JefferyWenn/EE400-Chip-Testing/file/EE400 - Memory Revival Sims & Layout.pdf

## Memory Revival Sims & Layout

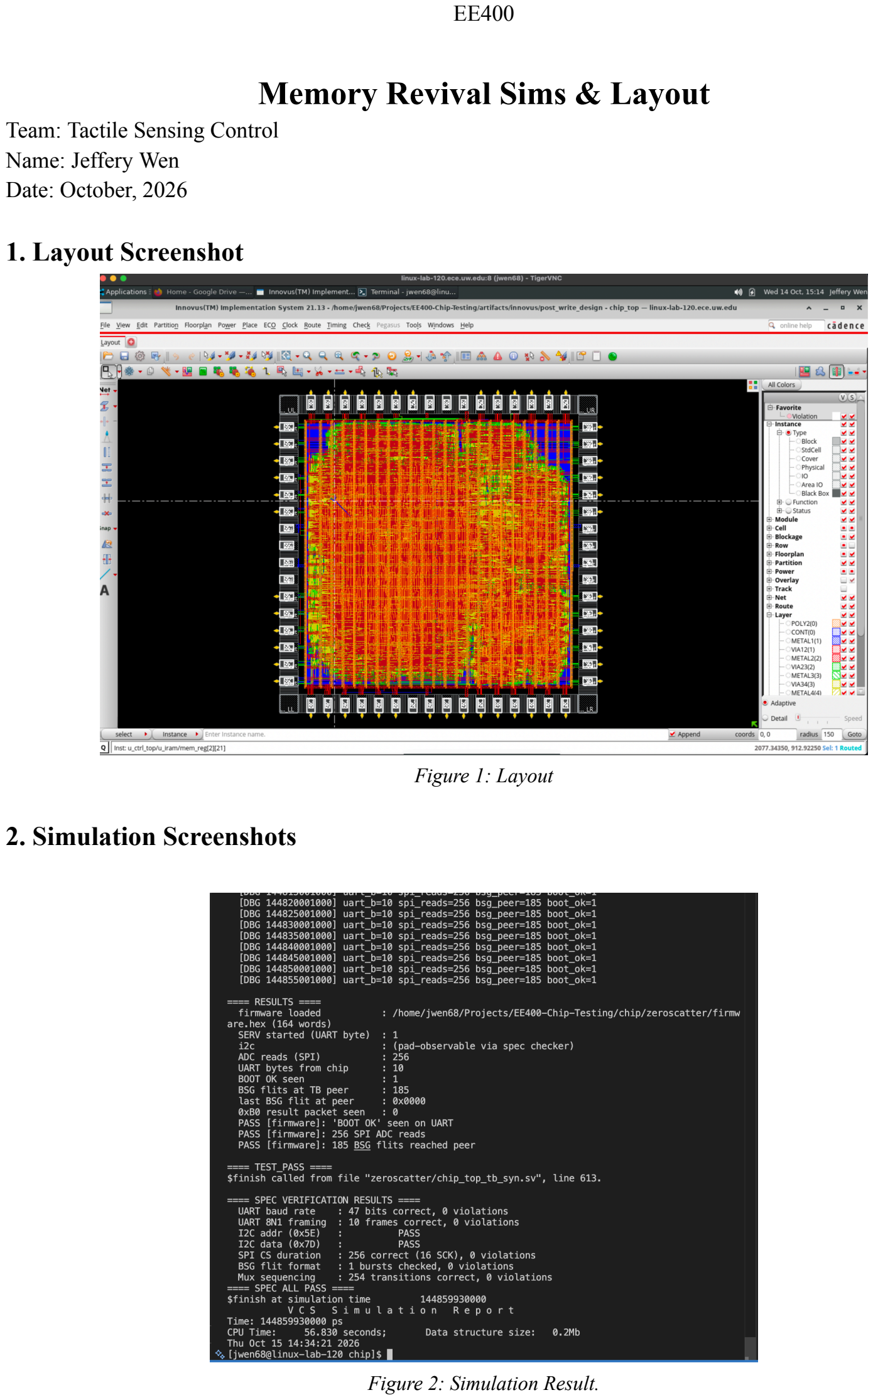
[picture p5: page 1]

EE400

Team: Tactile Sensing Control Name: Jeffery Wen
Date: October, 2026

### 1. Layout Screenshot

Figure 1: Layout

### 2. Simulation Screenshots

Figure 2: Simulation Result.

EE400

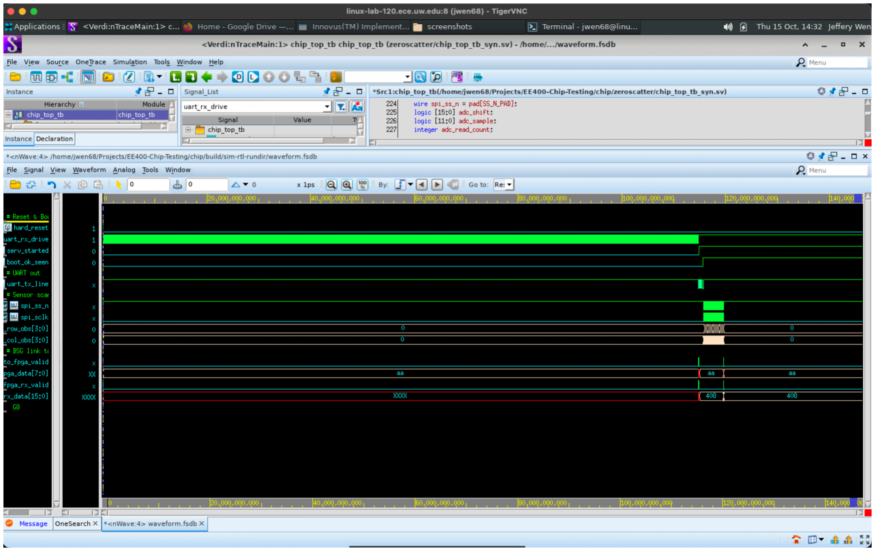
[picture p6: figure]

Figure 3: Simulation waveform.

### 3. Bring-up plan

We will test the chip step by step, starting with basic checks and then testing the full system.

Milestone 1: Any sign of life. Power up the chip (1.8 V core, 3.3 V IO), apply a clock and reset, and look for any activity on the outputs, such as the UART reply or the scan chain output. Any correct signal from the chip counts as success.

Milestone 2: Sub-modules work. Test each block on its own at a low clock (10 MHz):
- UART firmware loading and the "BOOT OK" message
- I²C sensor configuration
- SPI reads from the ADC and the mux scan across the 256 sensor cells
- the bsg_link chip-to-chip interface

Milestone 3: Test the full system at low speed. Run the complete process at 10 MHz: scan all 256 sensor cells, send the data to the conv chip, and receive the result through UART. If the results are correct, it shows that the full design works on the chip.

Milestone 4: Check the design targets. Increase the clock speed toward the original 50 MHz target and measure:
- The highest working clock speed at different supply voltages
- The frame rate (frames per second) of the full system
- Power use and energy used per frame

Milestone 5: Try other applications. After confirming that the chip works, explore its use in other sensing devices in Prof. Luo's lab, beyond the tactile glove.
