JefferyWenn/EE400-Chip-Testing/docs/clk_data_delay_output.png

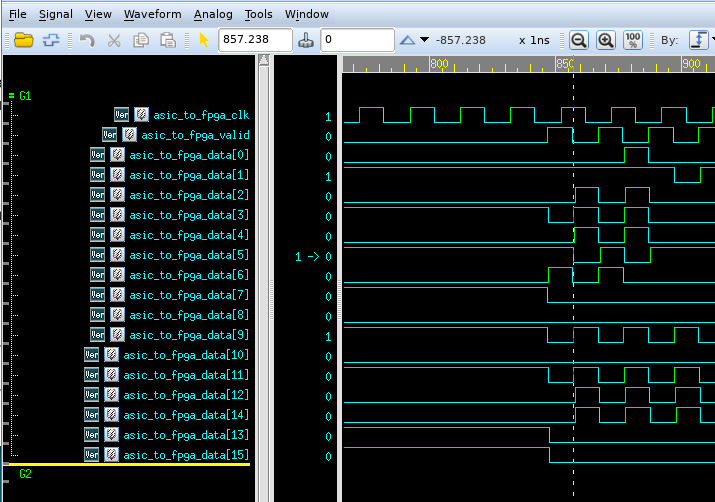
docs/clk_data_delay_output.png
