JefferyWenn/EE400-Chip-Testing/screenshots/Screenshot 2026-10-14 at 3.14.47 PM.png

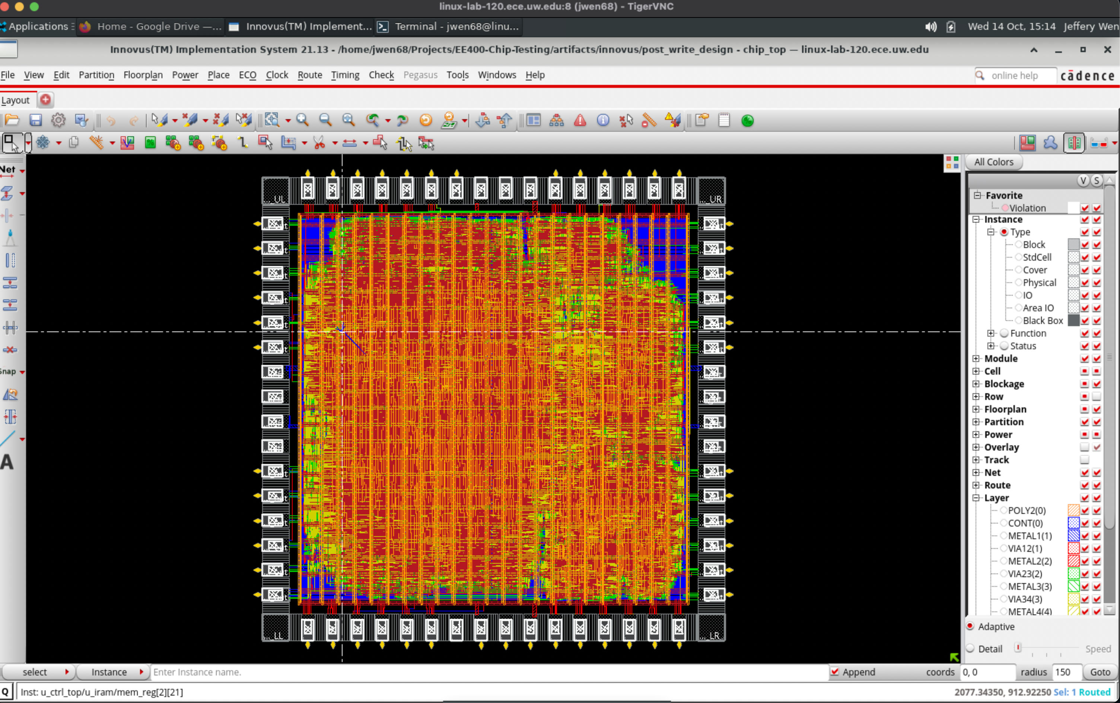
screenshots/Screenshot 2026-10-14 at 3.14.47 PM.png
