JefferyWenn/EE400-Chip-Testing/screenshots/Screenshot 2026-10-15 at 2.32.01 PM.png

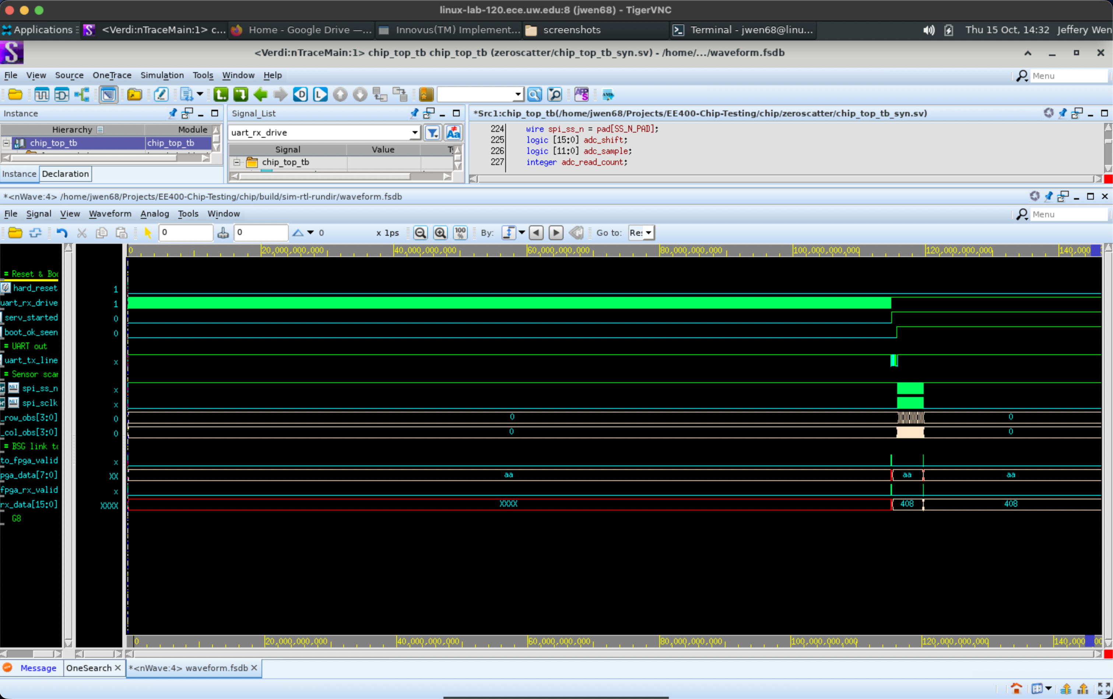
screenshots/Screenshot 2026-10-15 at 2.32.01 PM.png
