JefferyWenn/EE400-Chip-Testing/screenshots/Screenshot 2026-10-15 at 2.34.30 PM.png

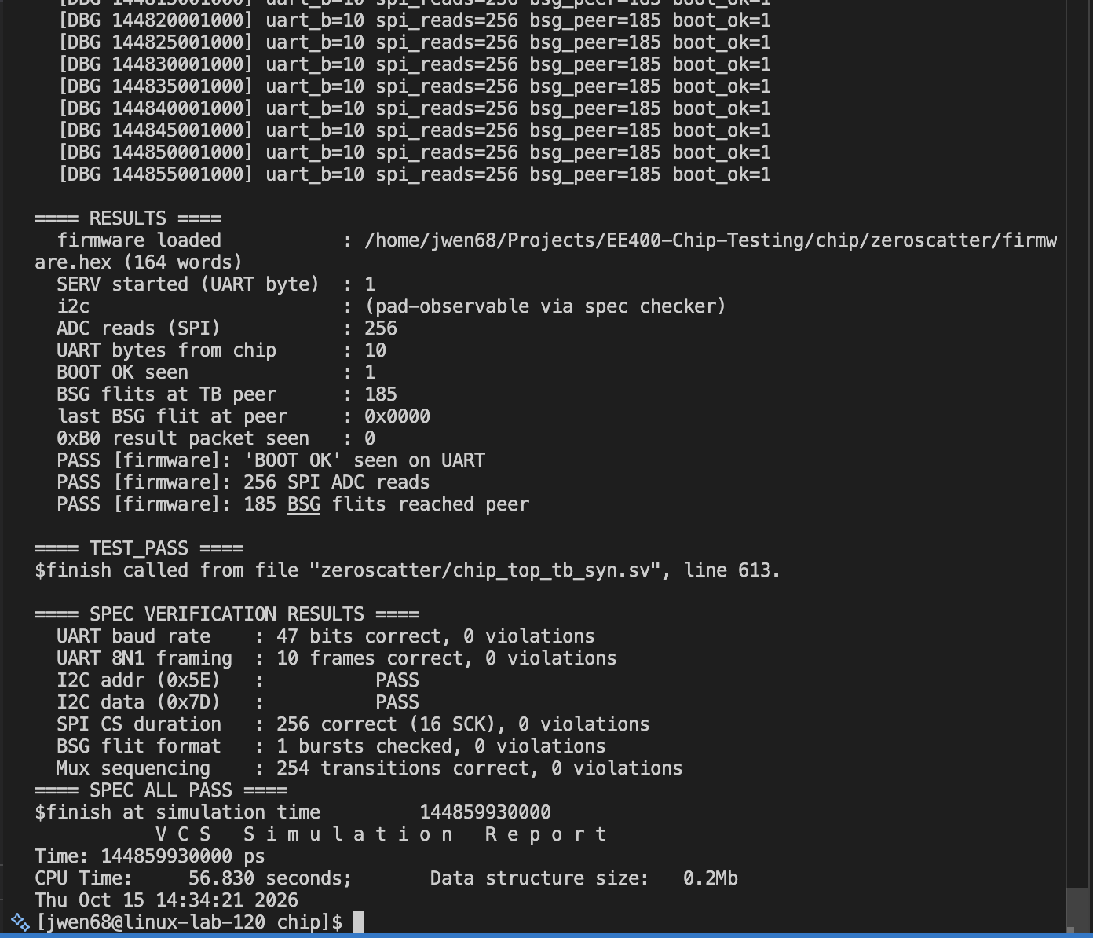
screenshots/Screenshot 2026-10-15 at 2.34.30 PM.png
