JefferyWenn/EE400-Chip-Testing/chip/zeroscatter/chip_top_tb.sv

// =====================================================================
// chip_top_tb.sv  —  Functional testbench for the tactile-sensing SoC
//
// Exercises the REAL design: firmware-driven SERV SoC that boots, scans
// 256 sensor cells over SPI, DMA-offloads them to a DLA over the BSG
// link, and streams a result packet back out over UART.
//
// TB actors:
//   1. Clock/reset driver    — core_clk PAD[44], hard_reset PAD[45]
//   2. Firmware loader       — FAST backdoor into IRAM (default), or real
//                              UART feed on PAD[24] (FAST_LOAD=0)
//   3. SPI ADC mock (AD7466) — drives MISO PAD[25] with fake samples when
//                              the chip drives SCLK PAD[13]/SS_n PAD[26]
//   4. BSG DLA mock          — bsg_link peer; drains chip BSG TX (so the
//                              DMA completes) and sends result flits back
//   5. UART TX monitor       — decodes PAD[27], detects "BOOT OK"
//
// Pass criteria (each failure increments errors):
//   - i2c_done asserts
//   - SERV comes out of reset and fetches (PC advances)
//   - "BOOT OK" string seen on UART TX
//   - chip emits >=1 BSG TX flit (proves scan + DMA ran)
//
// FROZEN-RTL NOTE: this chip_top wires ctrl_top.nRESET (active-low) to
// core_link_reset_int (active-high), which holds the core in reset forever.
// Since RTL is frozen, the TB FORCES nRESET high after the bsg reset
// sequencer settles (FORCE_NRESET=1). Remove once the RTL bug is fixed.
// =====================================================================
`timescale 1ps/1ps

module chip_top_tb;

    // ---- knobs ----
    // FAST_LOAD / DLA_RESPOND / DLA_EARLY are runtime-selectable so individual
    // +TEST cases can flip them (e.g. test_uart_boot exercises the REAL UART
    // firmware_loader with FAST_LOAD=0; test_rx fires the DLA mock immediately,
    // decoupled from the outbound DMA burst). Defaults below match the legacy
    // behaviour and are overridden in load_fw_file() per test_name.
    logic FAST_LOAD;                     // 1: backdoor IRAM. 0: real UART feed.
    localparam bit FORCE_NRESET = 1'b1;  // work around frozen nRESET wiring bug
    logic DLA_RESPOND;                   // DLA mock sends result flits back
    logic DLA_EARLY;                     // 1: DLA responds as soon as chip runs
                                         //    (decouples RX path from TX burst)

    localparam int FLIT_WIDTH    = 16;
    localparam int CHANNEL_WIDTH = 8;
    localparam int FW_MAX        = 1024;
    // Default firmware directory. Test selected by +TEST=name; directory can
    // be overridden by +FWDIR=/abs/path/ so the same simv runs on a grader's
    // machine without rebuilding. Keep the trailing slash on any override.
    localparam string FW_DIR_DEFAULT =
        "/home/jwen68/Projects/EE400-Chip-Testing/chip/zeroscatter/";
    string fw_dir;
    string fw_hex_path;

    localparam int      BAUD   = 115_200;
    localparam realtime BIT_PS = 1.0e12 / BAUD;   // real so # delays are exact

    // ---- pad indices (from chip_top.sv) ----
    localparam CORE_CLK_PAD=44, HARD_RESET_PAD=45;
    localparam DN_CLK_PAD=8, DN_VALID_PAD=9, DN_TOKEN_PAD=10, TOKEN_CLK_PAD=12;
    localparam UP_VALID_PAD=14, UP_CLK_PAD=15;
    localparam SCLK_PAD=13, MISO_PAD=25, SS_N_PAD=26;
    localparam UART_RX_PAD=24, UART_TX_PAD=27;
    localparam I2C_SCL_PAD=28, I2C_SDA_PAD=29;
    localparam MUX_ROW0_PAD=36, MUX_COL0_PAD=40;
    // At 50 MHz each core_clk period = 20 000 ps.
    // UART baud = 115 200 → divider = floor(50e6/115200) = 434 clocks/bit.
    localparam realtime BIT_PS_RTL = 434.0 * 20000.0; // 8 680 000 ps per bit

    // =================================================================
    //  Clocks + globals
    // =================================================================
    logic core_clk, dn_io_clk, hard_reset;
    logic fpga_core_reset, fpga_tx_io_link_reset, fpga_tx_async_token_reset;
    logic fpga_rx_io_link_reset, fpga_rx_io_link_reset_sync;

    initial begin core_clk = 0;  forever #10000 core_clk = ~core_clk; end
    initial begin dn_io_clk = 0; forever #10000 dn_io_clk = ~dn_io_clk; end

    // =================================================================
    //  Pad bus
    // =================================================================
    wire vdd_io = 1'b1, vss_io = 1'b0;
    tri  [47:0] pad;
    logic [47:0] pad_drv, pad_oe;

    function automatic logic kz(input logic v); kz = (v===1'b1)?1'b1:1'b0; endfunction

    genvar gi;
    generate
        for (gi=0; gi<48; gi++) begin: gen_pad
            assign pad[gi] = pad_oe[gi] ? pad_drv[gi] : 1'bz;
        end
    endgenerate

    chip_top uut (.PAD(pad), .VDDPST(vdd_io), .VSSPST(vss_io), .VDD(vdd_io), .VSS(vss_io));

    assign pad_drv[CORE_CLK_PAD]   = kz(core_clk);
    assign pad_drv[HARD_RESET_PAD] = kz(hard_reset);

    // =================================================================
    //  BSG link peer
    // =================================================================
    logic                     fpga_to_asic_clk, fpga_to_asic_valid, fpga_to_asic_token;
    logic [CHANNEL_WIDTH-1:0] fpga_to_asic_data;
    logic                     asic_to_fpga_clk, asic_to_fpga_valid, asic_to_fpga_token;
    logic [CHANNEL_WIDTH-1:0] asic_to_fpga_data;

    assign pad_drv[DN_CLK_PAD]    = kz(fpga_to_asic_clk);
    assign pad_drv[DN_VALID_PAD]  = kz(fpga_to_asic_valid);
    assign pad_drv[0]=kz(fpga_to_asic_data[0]); assign pad_drv[1]=kz(fpga_to_asic_data[1]);
    assign pad_drv[2]=kz(fpga_to_asic_data[2]); assign pad_drv[3]=kz(fpga_to_asic_data[3]);
    assign pad_drv[4]=kz(fpga_to_asic_data[4]); assign pad_drv[5]=kz(fpga_to_asic_data[5]);
    assign pad_drv[6]=kz(fpga_to_asic_data[6]); assign pad_drv[7]=kz(fpga_to_asic_data[7]);
    assign pad_drv[TOKEN_CLK_PAD] = kz(fpga_to_asic_token);

    assign asic_to_fpga_clk   = pad[UP_CLK_PAD];
    assign asic_to_fpga_valid = pad[UP_VALID_PAD];
    assign asic_to_fpga_token = pad[DN_TOKEN_PAD];
    assign asic_to_fpga_data[0]=pad[22]; assign asic_to_fpga_data[1]=pad[23];
    assign asic_to_fpga_data[2]=pad[20]; assign asic_to_fpga_data[3]=pad[21];
    assign asic_to_fpga_data[4]=pad[18]; assign asic_to_fpga_data[5]=pad[19];
    assign asic_to_fpga_data[6]=pad[16]; assign asic_to_fpga_data[7]=pad[17];

    logic [FLIT_WIDTH-1:0] fpga_tx_data, fpga_rx_data;
    logic fpga_tx_valid, fpga_tx_ready, fpga_rx_valid, fpga_rx_yumi;

    bsg_link_ddr_upstream #(
        .width_p(FLIT_WIDTH), .channel_width_p(CHANNEL_WIDTH),
        .num_channels_p(1), .lg_fifo_depth_p(6)
    ) fpga_tx_link (
        .core_clk_i(core_clk), .core_link_reset_i(fpga_core_reset),
        .core_data_i(fpga_tx_data), .core_valid_i(fpga_tx_valid), .core_ready_o(fpga_tx_ready),
        .io_clk_i(dn_io_clk), .io_link_reset_i(fpga_tx_io_link_reset),
        .async_token_reset_i(fpga_tx_async_token_reset),
        .io_clk_r_o(fpga_to_asic_clk), .io_data_r_o(fpga_to_asic_data),
        .io_valid_r_o(fpga_to_asic_valid), .token_clk_i(asic_to_fpga_token)
    );

    bsg_sync_sync #(.width_p(1)) fpga_rx_reset_sync (
        .oclk_i(asic_to_fpga_clk), .iclk_data_i(fpga_rx_io_link_reset),
        .oclk_data_o(fpga_rx_io_link_reset_sync)
    );

    bsg_link_ddr_downstream #(
        .width_p(FLIT_WIDTH), .channel_width_p(CHANNEL_WIDTH),
        .num_channels_p(1), .lg_fifo_depth_p(6)
    ) fpga_rx_link (
        .core_clk_i(core_clk), .core_link_reset_i(fpga_core_reset),
        .io_link_reset_i(fpga_rx_io_link_reset_sync),
        .core_data_o(fpga_rx_data), .core_valid_o(fpga_rx_valid), .core_yumi_i(fpga_rx_yumi),
        .io_clk_i(asic_to_fpga_clk), .io_data_i(asic_to_fpga_data),
        .io_valid_i(asic_to_fpga_valid), .core_token_r_o(fpga_to_asic_token)
    );

    // =================================================================
    //  DLA mock — drain chip TX; echo result flits after a full burst
    // =================================================================
    integer chip_tx_count;
    integer chip_bsg_accept_count;   // chip-internal BSG TX accept counter (firmware-direct only)
    integer dma_engine_flit_count;   // flits the DMA engine itself emits (u_up_ctl boundary)
    logic   dma_done_seen;           // BSG_UP_ST.done (u_up_ctl.o_done) ever asserted
    logic   dma_busy_seen;           // DMA engine ever entered busy
    logic   cnn_buf_ready_seen;       // moved to module scope (VCS error)
    logic [FLIT_WIDTH-1:0] chip_tx_last;

    assign fpga_rx_yumi = fpga_rx_valid;   // always accept

    always_ff @(posedge core_clk) begin
        if (fpga_core_reset) begin chip_tx_count <= 0; chip_tx_last <= '0; end
        else if (fpga_rx_valid && fpga_rx_yumi) begin
            chip_tx_count <= chip_tx_count + 1;
            chip_tx_last  <= fpga_rx_data;
        end
    end

    integer dla_idx;
    logic   responded;
    localparam int BURST_THRESHOLD = 258;   // chip sends ~259 flits, trigger when most are done

    // Early-arm: once the chip core is out of reset (serv_rst_n high) plus a
    // settling delay, allow the DLA mock to respond WITHOUT waiting for the
    // outbound DMA burst. Used by test_rx to exercise the RX -> cnn_result_buf
    // -> pkt_framer -> UART 0xB0 path in isolation.
    integer dla_early_cnt;
    logic   dla_early_armed;
    always_ff @(posedge core_clk) begin
        if (fpga_core_reset) begin
            dla_early_cnt   <= 0;
            dla_early_armed <= 1'b0;
        // RTL: gate on serv_rst_n; gate-level: gate on fpga_core_reset deassert
        // (fixed 2000-cycle settle, same effect since SERV starts shortly after)
`ifdef RTL_SIM
        end else if (uut.u_ctrl_top.serv_rst_n === 1'b1) begin
`else
        end else begin
`endif
            if (dla_early_cnt < 2000) dla_early_cnt <= dla_early_cnt + 1;
            else                      dla_early_armed <= 1'b1;
        end
    end
    // The DLA mock starts streaming its response when either trigger is true.
    wire dla_trigger = DLA_EARLY ? dla_early_armed
                                 : (chip_tx_count >= BURST_THRESHOLD);

    // 14-flit result packet:
    //   flit 0: HDR_HI with bits[3:2]=01 (PKT_DATA) — any value that has bits[3:2]=01
    //   flit 1: HDR_LO with bits[8:0]=12 (len)
    //   flits 2..13: 12 body flits → fill cnn_result_buf → buf_ready → pkt_framer fires
    function automatic [15:0] dla_resp_flit(input integer i);
        case (i)
            0: dla_resp_flit = 16'h0004;            // bits[3:2]=01 (PKT_DATA)
            1: dla_resp_flit = 16'h000C;            // len = 12
            default: dla_resp_flit = 16'hC000 | i;  // body flits 0xC002..0xC00D
        endcase
    endfunction

    // NOTE: fpga_tx_valid/data, dla_idx, responded reset inside this
    // always_ff ONLY — VCS forbids a second driver, so no initial block.
    always_ff @(posedge core_clk) begin
        if (fpga_core_reset) begin
            fpga_tx_valid<=0; fpga_tx_data<='0; dla_idx<=0; responded<=0;
        end else if (DLA_RESPOND && !responded && dla_trigger) begin
            if (fpga_tx_ready) begin
                fpga_tx_valid <= 1'b1;
                fpga_tx_data  <= dla_resp_flit(dla_idx);
                dla_idx <= dla_idx + 1;
                if (dla_idx == 13) responded <= 1'b1;
            end else fpga_tx_valid <= 1'b0;
        end else fpga_tx_valid <= 1'b0;
    end

    // =================================================================
    //  SPI ADC mock (AD7466)
    // =================================================================
    wire spi_sclk = pad[SCLK_PAD];
    wire spi_ss_n = pad[SS_N_PAD];
    logic [15:0] adc_shift;
    logic [11:0] adc_sample;
    integer adc_read_count;

    initial begin adc_sample=12'h080; adc_read_count=0; adc_shift='0; end
    always @(negedge spi_ss_n) begin
        adc_shift = {4'b0000, adc_sample};
        adc_read_count = adc_read_count + 1;
        adc_sample = adc_sample + 12'h007;
    end
    always @(negedge spi_sclk) if (!spi_ss_n) adc_shift = {adc_shift[14:0], 1'b0};
    assign pad_drv[MISO_PAD] = adc_shift[15];

    // =================================================================
    //  UART feeder (FAST_LOAD=0) + monitor
    // =================================================================
    logic uart_rx_drive;
    assign pad_drv[UART_RX_PAD] = uart_rx_drive;

    task automatic uart_send_byte(input [7:0] b);
        integer i;
        begin
            uart_rx_drive=1'b0; #(BIT_PS);
            for (i=0;i<8;i++) begin uart_rx_drive=b[i]; #(BIT_PS); end
            uart_rx_drive=1'b1; #(BIT_PS);
        end
    endtask
    task automatic loader_send_word(input [31:0] addr, input [31:0] data);
        begin
            uart_send_byte(addr[31:24]); uart_send_byte(addr[23:16]);
            uart_send_byte(addr[15:8]);  uart_send_byte(addr[7:0]);
            uart_send_byte(data[31:24]); uart_send_byte(data[23:16]);
            uart_send_byte(data[15:8]);  uart_send_byte(data[7:0]);
        end
    endtask

    wire uart_tx_line = pad[UART_TX_PAD];
    integer uart_rx_byte_count;
    logic [8*8-1:0] uart_win;
    logic boot_ok_seen;
    logic pkt_b0_seen;
    logic [7:0] last_uart_byte;

    task automatic uart_recv_byte(output [7:0] b);
        integer i;
        begin
            @(negedge uart_tx_line);
            #(BIT_PS + BIT_PS/2);
            for (i=0;i<8;i++) begin b[i]=uart_tx_line; #(BIT_PS); end
        end
    endtask

    initial begin
        uart_rx_byte_count=0; boot_ok_seen=0; uart_win='0; last_uart_byte=0;
        pkt_b0_seen=0;
        forever begin
            logic [7:0] rb;
            uart_recv_byte(rb);
            last_uart_byte=rb; uart_rx_byte_count=uart_rx_byte_count+1;
            uart_win = {uart_win[8*7-1:0], rb};
            if (rb >= 8'h20 && rb < 8'h7f)
                $display("  [%0t] UART TX #%0d = 0x%02h ('%c')", $time, uart_rx_byte_count, rb, rb);
            else
                $display("  [%0t] UART TX #%0d = 0x%02h", $time, uart_rx_byte_count, rb);
            if (uart_win == {"B","O","O","T"," ","O","K"}) boot_ok_seen=1;
            if (rb == 8'hB0) begin
                pkt_b0_seen = 1;
                $display("  [%0t] >> 0xB0 result packet header seen on UART!", $time);
            end
        end
    end

    // =================================================================
    //  Firmware image
    // =================================================================
    logic [31:0] fw_mem [0:FW_MAX-1];
    integer fw_words;
    string  test_name_g;   // set by load_fw_file; used for per-test pass criteria

    task automatic load_fw_file;
        integer i;
        string  test_name;
        begin
            // Pick which hex via +TEST=name plusarg. Default: firmware
            if (!$value$plusargs("TEST=%s", test_name)) test_name = "firmware";
            test_name_g = test_name;
            // Directory: +FWDIR=... overrides the baked-in absolute path.
            if (!$value$plusargs("FWDIR=%s", fw_dir)) fw_dir = FW_DIR_DEFAULT;
            fw_hex_path = {fw_dir, test_name, ".hex"};

            // ---- Per-test knob defaults ----
            // Most tests: backdoor IRAM (fast), DLA responds after a full burst.
            FAST_LOAD   = 1'b1;
            DLA_RESPOND = 1'b1;
            DLA_EARLY   = 1'b0;
            case (test_name)
                // Real UART boot: drive firmware in over PAD[24] via the
                // on-chip firmware_loader instead of backdooring IRAM.
                "test_uart_boot": FAST_LOAD = 1'b0;
                // RX/0xB0 path in isolation: fire the DLA response immediately
                // so cnn_result_buf -> pkt_framer -> UART 0xB0 runs without
                // depending on the outbound DMA burst reaching the peer.
                "test_rx":        DLA_EARLY = 1'b1;
                default: ;  // keep defaults
            endcase

            $display("==== Loading firmware: %s ====", fw_hex_path);
            $display("====   FAST_LOAD=%0b DLA_RESPOND=%0b DLA_EARLY=%0b ====",
                     FAST_LOAD, DLA_RESPOND, DLA_EARLY);
            for (i=0;i<FW_MAX;i++) fw_mem[i]=32'hxxxx_xxxx;
            $readmemh(fw_hex_path, fw_mem);
            fw_words=0;
            for (i=0;i<FW_MAX;i++) if (fw_mem[i]!==32'hxxxx_xxxx) fw_words=i+1;
            $display("Loaded %0d firmware words", fw_words);
            if (fw_words==0) $display("ERROR: no firmware loaded - check FW path!");
        end
    endtask

    // ---- Spec verification variables (declared here for forward-ref) ----
    int      uart_baud_ok, uart_baud_err;
    realtime uart_last_trans_ps;
    logic    uart_baud_armed;
    int      uart_frame_err, uart_frame_ok;
    logic [7:0] i2c_addr_captured, i2c_data_captured;
    logic       i2c_addr_valid, i2c_data_valid;
    int         i2c_spec_err;
    int spi_sck_per_cs, spi_cs_spec_ok, spi_cs_spec_err;
    int  bsg_flit_spec_err, bsg_burst_count, bsg_flit_idx_in_burst;
    logic bsg_in_burst;
    logic [3:0] mux_row_obs, mux_col_obs;
    logic [7:0] mux_prev_cell     = 8'd0;
    logic [7:0] mux_curr_cell     = 8'd0;
    logic [7:0] mux_expected_next = 8'd0;
    int         mux_seq_ok = 0, mux_seq_err = 0;
    logic       mux_first_cell = 1;

    // =================================================================
    //  Main sequence
    // =================================================================
    integer errors;
    logic   serv_started;

    initial begin
        // VCD dump disabled: full-design VCD is ~7 GB per run; waveform.fsdb below is used instead.
        // $dumpfile("chip_top_tb.vcd"); $dumpvars(0, chip_top_tb);
        $fsdbDumpfile("waveform.fsdb"); $fsdbDumpvars(0, chip_top_tb); $fsdbDumpMDA();

        errors=0; serv_started=0;
        hard_reset=1; fpga_core_reset=1;
        fpga_tx_io_link_reset=1; fpga_tx_async_token_reset=0; fpga_rx_io_link_reset=1;
        uart_rx_drive=1; pad_oe='0;

        load_fw_file();

        #1000;
        pad_oe[CORE_CLK_PAD]=1; pad_oe[HARD_RESET_PAD]=1;
        pad_oe[DN_CLK_PAD]=1; pad_oe[DN_VALID_PAD]=1; pad_oe[TOKEN_CLK_PAD]=1;
        pad_oe[UART_RX_PAD]=1; pad_oe[MISO_PAD]=1;
        for (int d=0; d<8; d++) pad_oe[d]=1;

        // bsg reset bring-up
        // Reset sequencing follows the bsg_link_ddr reference procedure:
        //   TX side: async_token_reset pulse → io_link_reset deassert
        //   Chip:    hard_reset deassert → internal sequencer runs (cnt 0..32)
        //   RX side: io_link_reset deassert after forwarded clk is stable
        //
        // ODDR phase fix: the forwarded clock (asic_to_fpga_clk) is generated
        // from negedges of core_clk. odd_r (which selects data_high vs
        // data_low+valid) starts at 0 after reset and toggles every core_clk.
        // The IDDR extracts the valid bit from data_p_r[8] (posedge sample).
        // For valid=1, posedge of asic_to_fpga_clk must align with odd_r=1
        // (data_low+valid half). Adding 1 extra core_clk before releasing
        // fpga_rx_io_link_reset shifts the phase by one cycle to achieve this.
        // Similarly, 1 extra dn_io_clk before fpga_tx_io_link_reset aligns
        // the chip's IDDR for the FPGA-TX → chip-RX direction.
        repeat (8) @(posedge core_clk);
        fpga_tx_async_token_reset=1; repeat (2) @(posedge core_clk); fpga_tx_async_token_reset=0;
        repeat (9) @(posedge dn_io_clk); fpga_tx_io_link_reset=0;   // +1 for chip RX IDDR phase
        repeat (8) @(posedge core_clk);
        hard_reset=0;
        repeat (65) @(posedge core_clk);                             // +1 for FPGA RX IDDR phase
        fpga_rx_io_link_reset=0;
        repeat (8) @(posedge core_clk);
        fpga_core_reset=0;
        repeat (50) @(posedge core_clk);

        if (FORCE_NRESET) begin
            force uut.u_ctrl_top.nRESET = 1'b1;
            $display("==== NOTE: forcing u_ctrl_top.nRESET=1 (frozen-RTL workaround) ====");
        end

        // STEP 1 — load firmware
        if (FAST_LOAD) begin
            $display("\n==== STEP 1: FAST backdoor load (%0d words) ====", fw_words);
            for (int w=0; w<fw_words; w++) uut.u_ctrl_top.u_iram.mem[w] = fw_mem[w];
            // SP patch: only applies to the real firmware which uses a stack.
            // Test programs don't use a stack so no patch needed.
            // If you need it, uncomment:
            // uut.u_ctrl_top.u_iram.mem[1] = 32'h10010113;  // SP=0x100
            force uut.u_ctrl_top.iram_load_done = 1'b1;
            force uut.u_ctrl_top.iram_ack_done  = 1'b1;
            $display("==== STEP 1: firmware backdoored, loader-done forced ====");
        end else begin
            $display("\n==== STEP 1: UART firmware feed (%0d words) ====", fw_words);
            uart_send_byte(8'hAA); uart_send_byte(8'h55);
            for (int w=0; w<fw_words; w++) loader_send_word(w[31:0], fw_mem[w]);
            loader_send_word(32'hFFFF_FFFF, 32'hDEAD_BEEF);
            $display("==== firmware sent ====");
        end

        // wait for i2c_done
        fork : i2c_wait
            begin wait (uut.u_ctrl_top.i2c_done === 1'b1);
                  $display("==== i2c_done asserted ===="); disable i2c_wait; end
            begin repeat (60000) @(posedge core_clk);
                  $display("==== WARN: i2c_done not seen ===="); errors++; disable i2c_wait; end
        join

        // STEP 2 — run
        // For real UART boot (FAST_LOAD=0), firmware_loader takes ~1.7M cycles
        // to receive and process the binary before iram_ack_done asserts and
        // SERV starts. Wait for iram_ack_done first so the 2000-cycle PC check
        // window opens at the right time.
        $display("\n==== STEP 2: SERV boot + run ====");
        if (!FAST_LOAD) begin
            fork : ack_wait
                begin wait (uut.u_ctrl_top.iram_ack_done === 1'b1);
                      $display("==== iram_ack_done asserted — SERV starting ====");
                      disable ack_wait; end
                begin repeat (3_000_000) @(posedge core_clk);
                      $display("==== WARN: iram_ack_done timeout ====");
                      errors++; disable ack_wait; end
            join
        end
        begin
            integer pc0;
            pc0 = uut.u_ctrl_top.ibus_adr;
            repeat (2000) @(posedge core_clk);
            if (uut.u_ctrl_top.ibus_adr !== pc0) serv_started=1;
        end

        repeat (1_500_000) @(posedge core_clk);

        // RESULTS
        $display("\n==== RESULTS ====");
        $display("  firmware loaded           : %s (%0d words)", fw_hex_path, fw_words);
        $display("  SERV PC advanced          : %0d (now 0x%h)", serv_started, uut.u_ctrl_top.ibus_adr);
        $display("  i2c_done                  : %b", uut.u_ctrl_top.i2c_done);
        $display("  ADC reads (SPI)           : %0d", adc_read_count);
        $display("  UART bytes from chip      : %0d", uart_rx_byte_count);
        $display("  BOOT OK seen (legacy)     : %0d", boot_ok_seen);
        $display("  BSG accepted (fw direct)  : %0d", chip_bsg_accept_count);
        $display("  DMA engine flits emitted  : %0d", dma_engine_flit_count);
        $display("  DMA engine went busy      : %0d", dma_busy_seen);
        $display("  DMA engine done (UP_ST)   : %0d", dma_done_seen);
        $display("  BSG flits at TB peer      : %0d", chip_tx_count);
        $display("  last BSG flit at peer     : 0x%04h", chip_tx_last);
        $display("  cnn_result_buf ready      : %0d", cnn_buf_ready_seen);
        $display("  0xB0 result packet seen   : %0d", pkt_b0_seen);

        // ---- Universal pass criteria (apply to any test) ----
        if (!serv_started)
            begin $display("  FAIL: SERV PC never advanced"); errors++; end

        // ---- Per-test pass criteria (based on which hex was loaded) ----
        case (test_name_g)

            "test_uart": begin
                // Firmware sends 9 UART bytes ("BOOT OK\r\n")
                if (uart_rx_byte_count < 9)
                    begin $display("  FAIL [test_uart]: only %0d UART bytes (expected 9)", uart_rx_byte_count); errors++; end
                else $display("  PASS [test_uart]: %0d UART bytes received", uart_rx_byte_count);
                if (uart_baud_err > 0)
                    begin $display("  FAIL [test_uart]: %0d baud rate violations", uart_baud_err); errors++; end
                else $display("  PASS [test_uart]: UART baud rate correct (434 clocks/bit)");
                if (uart_frame_err > 0)
                    begin $display("  FAIL [test_uart]: %0d 8N1 framing violations", uart_frame_err); errors++; end
                else $display("  PASS [test_uart]: UART 8N1 framing correct");
            end

            "test_scan": begin
                // Firmware scans all 256 sensor cells via SPI
                if (adc_read_count != 256)
                    begin $display("  FAIL [test_scan]: %0d SPI reads (expected 256)", adc_read_count); errors++; end
                else $display("  PASS [test_scan]: 256 SPI ADC reads completed");
                if (spi_cs_spec_err > 0)
                    begin $display("  FAIL [test_scan]: %0d SPI CS duration violations", spi_cs_spec_err); errors++; end
                else $display("  PASS [test_scan]: SPI CS held for 16 SCK pulses per read");
                if (mux_seq_err > 0)
                    begin $display("  FAIL [test_scan]: %0d mux sequencing violations", mux_seq_err); errors++; end
                else $display("  PASS [test_scan]: mux row/col advances correctly through all 256 cells");
            end

            "test_dma": begin
                // Firmware triggers ONE BSG DMA burst after scan, polls UP_ST.done.
                // Authoritative check is the DMA-engine boundary counter, which
                // is independent of off-chip link calibration. The peer-link
                // count is reported as additional (non-fatal) end-to-end info.
                if (!dma_busy_seen)
                    begin $display("  FAIL [test_dma]: DMA engine never went busy (GO/trigger never reached u_up_ctl)"); errors++; end
                else $display("  PASS [test_dma]: DMA engine entered busy");
                // Unpacked 256-element frame: 2 hdr + 256 body + 2 kickoff = 260 flits.
                if (dma_engine_flit_count < 260)
                    begin $display("  FAIL [test_dma]: DMA engine emitted only %0d flits (expected 260)", dma_engine_flit_count); errors++; end
                else $display("  PASS [test_dma]: DMA engine emitted %0d flits", dma_engine_flit_count);
                if (!dma_done_seen)
                    begin $display("  FAIL [test_dma]: BSG_UP_ST.done never asserted (firmware would hang in poll loop)"); errors++; end
                else $display("  PASS [test_dma]: BSG_UP_ST.done asserted (firmware poll loop completed)");
                // End-to-end peer link is informational here (proven in test_dma_e2e).
                if (chip_tx_count == 0)
                    $display("  INFO [test_dma]: 0 flits reached TB peer (off-chip link calibration; see test_dma_e2e)");
                else
                    $display("  INFO [test_dma]: %0d flits reached TB peer", chip_tx_count);
            end

            "test_dma_e2e": begin
                // FULL loop: scan -> DMA -> BSG link -> DLA mock -> RX ->
                // cnn_result_buf -> pkt_framer -> UART 0xB0. This is the
                // biggest-risk silicon path proven end to end.
                if (dma_engine_flit_count == 0)
                    begin $display("  FAIL [test_dma_e2e]: DMA engine emitted no flits"); errors++; end
                else $display("  PASS [test_dma_e2e]: DMA engine emitted %0d flits", dma_engine_flit_count);
                if (chip_tx_count < BURST_THRESHOLD)
                    begin $display("  FAIL [test_dma_e2e]: only %0d flits reached TB peer (expected >=%0d) - BSG link drops flits",
                                   chip_tx_count, BURST_THRESHOLD); errors++; end
                else $display("  PASS [test_dma_e2e]: %0d flits reached TB peer over BSG link", chip_tx_count);
                if (!cnn_buf_ready_seen)
                    begin $display("  FAIL [test_dma_e2e]: DLA response never captured in cnn_result_buf"); errors++; end
                else $display("  PASS [test_dma_e2e]: cnn_result_buf captured DLA response");
                if (!pkt_b0_seen)
                    begin $display("  FAIL [test_dma_e2e]: 0xB0 result packet never emitted on UART"); errors++; end
                else $display("  PASS [test_dma_e2e]: 0xB0 result packet emitted on UART (full loop closed)");
            end

            "test_rx": begin
                // RX/0xB0 path IN ISOLATION: DLA mock fires early (DLA_EARLY),
                // independent of any outbound DMA burst. Proves the inbound
                // DLA-response decode + framing path on its own.
                if (chip_tx_count != 0)
                    $display("  INFO [test_rx]: %0d outbound flits seen (not required for this test)", chip_tx_count);
                if (!cnn_buf_ready_seen)
                    begin $display("  FAIL [test_rx]: cnn_result_buf never went ready (RX decode path broken)"); errors++; end
                else $display("  PASS [test_rx]: cnn_result_buf captured injected DLA response");
                if (!pkt_b0_seen)
                    begin $display("  FAIL [test_rx]: 0xB0 packet never reached UART (pkt_framer path broken)"); errors++; end
                else $display("  PASS [test_rx]: 0xB0 result packet emitted on UART");
            end

            "test_uart_boot": begin
                // REAL UART firmware boot: FAST_LOAD=0, so firmware was driven
                // in over PAD[24] via the on-chip firmware_loader (AA 55 ...).
                // If the loader works, iram_ack_done asserts, SERV runs the
                // loaded program (test_uart image -> emits "BOOT OK\r\n"), and
                // we see UART bytes back.
                if (uut.u_ctrl_top.iram_ack_done !== 1'b1)
                    begin $display("  FAIL [test_uart_boot]: firmware_loader never asserted iram_ack_done"); errors++; end
                else $display("  PASS [test_uart_boot]: firmware_loader completed (iram_ack_done=1)");
                if (!serv_started)
                    begin $display("  FAIL [test_uart_boot]: SERV did not run UART-loaded firmware"); errors++; end
                else $display("  PASS [test_uart_boot]: SERV executed UART-loaded firmware");
                if (uart_rx_byte_count < 9)
                    begin $display("  FAIL [test_uart_boot]: only %0d UART bytes after boot (expected 9)", uart_rx_byte_count); errors++; end
                else $display("  PASS [test_uart_boot]: %0d UART bytes after real UART boot", uart_rx_byte_count);
            end

            "test_bsg_tx": begin
                // Firmware writes 8 flits directly to BSG_TX register
                if (chip_bsg_accept_count != 8)
                    begin $display("  FAIL [test_bsg_tx]: %0d BSG accepts (expected 8)", chip_bsg_accept_count); errors++; end
                else $display("  PASS [test_bsg_tx]: 8 BSG TX flits accepted");
                if (bsg_flit_spec_err > 0)
                    begin $display("  FAIL [test_bsg_tx]: %0d BSG flit format violations", bsg_flit_spec_err); errors++; end
            end

            "test_full": begin
                // Firmware scans 256 cells + sends UART output
                if (adc_read_count != 256)
                    begin $display("  FAIL [test_full]: %0d SPI reads (expected 256)", adc_read_count); errors++; end
                else $display("  PASS [test_full]: 256 SPI reads");
                if (uart_rx_byte_count == 0)
                    begin $display("  FAIL [test_full]: no UART output"); errors++; end
                else $display("  PASS [test_full]: %0d UART bytes", uart_rx_byte_count);
            end

            "firmware": begin
                // Default full firmware: BOOT OK + 256 SPI reads + BSG TX
                if (!boot_ok_seen)
                    begin $display("  FAIL [firmware]: 'BOOT OK' not seen on UART"); errors++; end
                else $display("  PASS [firmware]: 'BOOT OK' seen on UART");
                if (adc_read_count < 256)
                    begin $display("  FAIL [firmware]: only %0d SPI reads", adc_read_count); errors++; end
                else $display("  PASS [firmware]: %0d SPI ADC reads", adc_read_count);
                if (chip_bsg_accept_count == 0)
                    $display("  WARN [firmware]: no BSG TX (BSG link calibration may not have completed)");
                else $display("  PASS [firmware]: %0d BSG TX accepts", chip_bsg_accept_count);
            end

            default: begin
                // Unknown test — fall back to generic check
                if (uart_rx_byte_count == 0 && chip_tx_count == 0 && chip_bsg_accept_count == 0)
                    begin $display("  FAIL: no chip output observed"); errors++; end
            end
        endcase

        // ---- Informational notes ----
        if (cnn_buf_ready_seen)
            $display("  INFO: cnn_result_buf captured DLA response");
        if (pkt_b0_seen)
            $display("  INFO: 0xB0 result packet emitted on UART (pkt_framer fired)");

        if (errors == 0) $display("\n==== TEST_PASS ====");
        else             $display("\n==== TEST_FAIL (errors=%0d) ====", errors);

        $finish;
    end

    // ---- Probe: every time SERV writes BSG_TX, print it ----
    // chip_bsg_accept_count = chip-internal validation: count flits the
    // chip's bsg_link accepts. This is the authoritative "BSG TX works"
    // metric, independent of whether the TB peer downstream catches them.
    initial chip_bsg_accept_count = 0;

    always @(posedge core_clk) begin
        if (uut.u_ctrl_top.wr_bsg_tx)
            $display("  [%0t] >> wr_bsg_tx pulse, data=0x%h",
                     $time, uut.u_ctrl_top.dbus_wdata[15:0]);
        if (uut.u_ctrl_top.bsg_tx_fw_valid &&
            uut.u_ctrl_top.bsg_tx_ready &&
            !uut.u_ctrl_top.up_ctl_busy) begin
            $display("  [%0t] >> bsg_tx flit accepted, data=0x%h",
                     $time, uut.u_ctrl_top.bsg_tx_fw_data);
            chip_bsg_accept_count <= chip_bsg_accept_count + 1;
        end
        if (fpga_rx_valid)
            $display("  [%0t] >> fpga_rx side: valid=1 data=0x%h yumi=%b",
                     $time, fpga_rx_data, fpga_rx_yumi);
    end

    // ---- DMA-engine boundary probe (authoritative "DMA ran" metric) --------
    // chip_bsg_accept_count above counts only firmware-DIRECT writes (it
    // explicitly excludes up_ctl_busy). It NEVER counts DMA flits, so it
    // cannot prove the scan->DMA path. Here we tap the DMA engine's own TX
    // handshake (u_up_ctl.o_bsg_tx_valid & i_bsg_tx_ready) — every flit the
    // DMA controller hands to bsg_link, independent of whether the off-chip
    // peer link calibrates and catches them. We also latch the BSG_UP_ST done
    // bit (u_up_ctl.o_done) that the firmware itself polls, and whether the
    // engine ever went busy. Together these isolate three failure modes:
    //   busy never set        -> GO/trigger never reached the engine
    //   busy set, 0 flits      -> engine stalled (bsg_tx_ready stuck low)
    //   flits>0, peer count 0  -> engine works; off-chip link calibration lost them
    initial begin dma_engine_flit_count = 0; dma_done_seen = 0; dma_busy_seen = 0; end
    always @(posedge core_clk) begin
        if (uut.u_ctrl_top.u_up_ctl.o_bsg_tx_valid &&
            uut.u_ctrl_top.u_up_ctl.i_bsg_tx_ready) begin
            dma_engine_flit_count <= dma_engine_flit_count + 1;
        end
        if (uut.u_ctrl_top.up_ctl_busy) dma_busy_seen <= 1'b1;
        if (uut.u_ctrl_top.u_up_ctl.o_done && !dma_done_seen) begin
            dma_done_seen <= 1'b1;
            $display("  [%0t] >> DMA engine asserted done (BSG_UP_ST.done)", $time);
        end
    end

    // Watch cnn_result_buf fill (proves DLA response + buf decode path works)
    initial cnn_buf_ready_seen = 0;
    always @(posedge core_clk) begin
        if (uut.u_ctrl_top.u_cbuf.o_buf_ready && !cnn_buf_ready_seen) begin
            cnn_buf_ready_seen <= 1;
            $display("  [%0t] >> cnn_result_buf ready! (DLA response captured)", $time);
        end
    end

    // Debug heartbeat (~every 5us)
    initial begin
        #1000;
        forever begin
            #(250*20000);
            $display("  [DBG %0t] nRESET=%b i2c=%b serv_rst_n=%b PC=0x%h spi_cs=%b bsg_rdy=%b uart_b=%0d bsg_tx=%0d",
                     $time, uut.u_ctrl_top.nRESET, uut.u_ctrl_top.i2c_done,
                     uut.u_ctrl_top.serv_rst_n, uut.u_ctrl_top.ibus_adr,
                     uut.u_ctrl_top.spi_cs_n_o, uut.u_ctrl_top.bsg_tx_ready,
                     uart_rx_byte_count, chip_tx_count);
        end
    end

    // Hard watchdog
    initial begin
        #60_000_000_000_000;   // 60 ms ceiling
        $display("ERROR: watchdog expired");
        $display("==== TEST_FAIL (watchdog) ====");
        $finish;
    end

    // =================================================================
    // SPEC VERIFICATION — checks that current tests never validated
    // =================================================================

    // -----------------------------------------------------------------
    // 1. UART baud rate (spec: each bit = 434 core_clk cycles = 8 680 000 ps)
    // -----------------------------------------------------------------
    initial begin uart_baud_ok=0; uart_baud_err=0; uart_last_trans_ps=0; uart_baud_armed=0; end

    // Arm baud checker once the first UART byte arrives.
    // Reset uart_last_trans_ps=0 so the first armed transition just sets the
    // reference (no check), avoiding a stale mid-byte reference from the
    // unarmed phase.
    always @(uart_rx_byte_count) if (uart_rx_byte_count >= 1) begin
        uart_baud_armed    = 1;
        uart_last_trans_ps = 0;
    end

    always @(pad[UART_TX_PAD]) begin
        if (!uart_baud_armed) begin
            // Not yet armed — just record timestamp, don't check
            uart_last_trans_ps = $realtime;
        end else if (uart_last_trans_ps > 0) begin
            realtime delta_ps, expected_ps, err_ps;
            int n_bits;
            delta_ps   = $realtime - uart_last_trans_ps;
            n_bits     = $rtoi(delta_ps / BIT_PS_RTL + 0.5);
            expected_ps = n_bits * BIT_PS_RTL;
            err_ps     = delta_ps - expected_ps;
            if (n_bits < 1 || err_ps > 1000.0 || err_ps < -1000.0) begin
                uart_baud_err++;
                $display("  SPEC FAIL [UART baud]: %0.0fps for %0d bits, expected %0.0fps (err=%0.0fps) at %0t",
                         delta_ps, n_bits, expected_ps, err_ps, $time);
            end else
                uart_baud_ok++;
            uart_last_trans_ps = $realtime;
        end else
            uart_last_trans_ps = $realtime;
    end

    // -----------------------------------------------------------------
    // 2. UART 8N1 framing (spec: start=0, 8 data bits, stop=1)
    // -----------------------------------------------------------------
    initial uart_frame_err = 0;
    always begin : uart_frame_checker
        logic [7:0] b;
        logic stop;
        @(negedge kz(pad[UART_TX_PAD]));        // start bit
        #(BIT_PS + BIT_PS/2);                   // advance to mid-bit 0
        for (int i = 0; i < 8; i++) begin
            b[i] = kz(pad[UART_TX_PAD]);
            #(BIT_PS);
        end
        stop = kz(pad[UART_TX_PAD]);             // sample stop bit
        if (stop !== 1'b1) begin
            uart_frame_err++;
            $display("  SPEC FAIL [UART framing]: stop bit=0 (byte=0x%02h) at %0t", b, $time);
        end else
            uart_frame_ok++;
    end

    // -----------------------------------------------------------------
    // 3. I2C protocol spec: decode address (0x5E) and data (0x7D)
    // -----------------------------------------------------------------

    initial begin : i2c_decoder
        logic scl, sda, prev_sda;
        logic [7:0] shift;
        int bit_idx;

        i2c_addr_valid = 0; i2c_data_valid = 0; i2c_spec_err = 0;
        // Wait for START: SDA falls while SCL high
        @(negedge kz(pad[I2C_SDA_PAD]) iff kz(pad[I2C_SCL_PAD]));
        // Decode address byte (8 bits, MSB first), sampled on SCL rising
        for (bit_idx = 7; bit_idx >= 0; bit_idx--) begin
            @(posedge kz(pad[I2C_SCL_PAD]));
            shift[bit_idx] = kz(pad[I2C_SDA_PAD]);
        end
        i2c_addr_captured = shift;
        i2c_addr_valid = 1;
        if (shift !== 8'h5E)
            $display("  SPEC FAIL [I2C addr]: 0x%02h expected 0x5E at %0t", shift, $time);
        else
            $display("  SPEC PASS [I2C addr]: 0x5E correct");
        // Skip ACK clock
        @(posedge kz(pad[I2C_SCL_PAD]));
        // Decode data byte
        for (bit_idx = 7; bit_idx >= 0; bit_idx--) begin
            @(posedge kz(pad[I2C_SCL_PAD]));
            shift[bit_idx] = kz(pad[I2C_SDA_PAD]);
        end
        i2c_data_captured = shift;
        i2c_data_valid = 1;
        if (shift !== 8'h7D)
            $display("  SPEC FAIL [I2C data]: 0x%02h expected 0x7D at %0t", shift, $time);
        else
            $display("  SPEC PASS [I2C data]: 0x7D correct");
    end

    // SVA: SDA must not change while SCL is high
    // (START = SDA falls while SCL high; STOP = SDA rises while SCL high — both allowed)
    // We flag unexpected SDA changes as violations.
    int i2c_sda_violations;
    initial i2c_sda_violations = 0;
    always @(pad[I2C_SDA_PAD]) begin
        if (kz(pad[I2C_SCL_PAD]) && uut.u_ctrl_top.i2c_done === 1'b0) begin
            // SDA changed while SCL high during active I2C init.
            // START and STOP are the only valid transitions — we count but don't error,
            // since the state machine intentionally generates them.
            // Any mid-byte SDA change would be a real violation.
        end
    end

    // -----------------------------------------------------------------
    // 4. SPI CS duration (spec: CS low for exactly 16 SCK pulses per ADC read)
    // -----------------------------------------------------------------

    always @(negedge kz(pad[SS_N_PAD])) begin : spi_spec
        spi_sck_per_cs = 0;
    end
    always @(posedge kz(pad[SCLK_PAD])) begin
        if (!kz(pad[SS_N_PAD])) spi_sck_per_cs++;
    end
    always @(posedge kz(pad[SS_N_PAD])) begin
        if (spi_sck_per_cs > 0) begin
            if (spi_sck_per_cs !== 16) begin
                spi_cs_spec_err++;
                $display("  SPEC FAIL [SPI CS]: %0d SCK pulses expected 16 at %0t",
                         spi_sck_per_cs, $time);
            end else
                spi_cs_spec_ok++;
        end
    end

    // -----------------------------------------------------------------
    // 5. BSG TX flit format (spec: DATA header HI=0x0404)
    // -----------------------------------------------------------------
    initial begin bsg_flit_spec_err=0; bsg_burst_count=0; bsg_flit_idx_in_burst=0; bsg_in_burst=0; end
    always @(posedge core_clk) begin
        if (uut.u_ctrl_top.u_up_ctl.o_bsg_tx_valid &&
            uut.u_ctrl_top.bsg_tx_ready_i) begin
            bsg_flit_idx_in_burst++;
            case (bsg_flit_idx_in_burst)
                1: begin  // DATA header HI
                    if (uut.u_ctrl_top.u_up_ctl.o_bsg_tx_data !== 16'h0404) begin
                        bsg_flit_spec_err++;
                        $display("  SPEC FAIL [BSG hdr_hi]: 0x%04h expected 0x0404 at %0t",
                                 uut.u_ctrl_top.u_up_ctl.o_bsg_tx_data, $time);
                    end else
                        $display("  SPEC PASS [BSG hdr_hi]: 0x0404 correct");
                end
                2: begin  // DATA header LO (packed len=128 or unpacked len=256)
                    if (uut.u_ctrl_top.u_up_ctl.o_bsg_tx_data[15:9] !== 7'h0) begin
                        bsg_flit_spec_err++;
                        $display("  SPEC FAIL [BSG hdr_lo]: upper bits non-zero 0x%04h at %0t",
                                 uut.u_ctrl_top.u_up_ctl.o_bsg_tx_data, $time);
                    end else
                        $display("  SPEC PASS [BSG hdr_lo]: 0x%04h (len=%0d)",
                                 uut.u_ctrl_top.u_up_ctl.o_bsg_tx_data,
                                 uut.u_ctrl_top.u_up_ctl.o_bsg_tx_data[8:0]);
                end
            endcase
        end else if (!uut.u_ctrl_top.u_up_ctl.o_busy && bsg_flit_idx_in_burst > 0) begin
            // burst ended
            bsg_burst_count++;
            bsg_flit_idx_in_burst = 0;
        end
    end

    // -----------------------------------------------------------------
    // 6. Mux row/col sequencing (spec: 0→255 in order during scan)
    // -----------------------------------------------------------------

    assign mux_row_obs = {kz(pad[MUX_ROW0_PAD+3]), kz(pad[MUX_ROW0_PAD+2]),
                          kz(pad[MUX_ROW0_PAD+1]), kz(pad[MUX_ROW0_PAD])};
    assign mux_col_obs = {kz(pad[MUX_COL0_PAD+3]), kz(pad[MUX_COL0_PAD+2]),
                          kz(pad[MUX_COL0_PAD+1]), kz(pad[MUX_COL0_PAD])};

    always @(posedge core_clk) begin
        mux_curr_cell      = {mux_row_obs, mux_col_obs};
        mux_expected_next  = mux_prev_cell + 8'd1;  // compute before any update
        if (uut.u_ctrl_top.scan_busy &&
            mux_curr_cell !== mux_prev_cell) begin
            if (!mux_first_cell) begin
                if (mux_curr_cell !== mux_expected_next) begin
                    mux_seq_err++;
                    $display("  SPEC FAIL [MUX seq]: cell 0x%02h→0x%02h expected 0x%02h at %0t",
                             mux_prev_cell, mux_curr_cell, mux_expected_next, $time);
                end else
                    mux_seq_ok++;
            end
            mux_first_cell = 0;
            mux_prev_cell  = mux_curr_cell;  // update AFTER check
        end
    end

    // -----------------------------------------------------------------
    // 7. Spec summary — printed alongside the existing RESULTS block
    // -----------------------------------------------------------------
    initial begin : spec_summary
        // Wait until the main initial block calls $finish — intercept by
        // watching for the end-of-sim event from the results block.
        @(negedge uut.u_ctrl_top.serv_rst_n);   // wait until reset at least started
        wait (uut.u_ctrl_top.serv_rst_n);
        repeat (2_000_000) @(posedge core_clk);  // let simulation run fully
        // (Main initial block will $finish before this fires in normal runs)
    end

    // Report spec results at end of sim
    final begin
        $display("\n==== SPEC VERIFICATION RESULTS ====");
        $display("  UART baud rate    : %0d bits correct, %0d violations",
                 uart_baud_ok, uart_baud_err);
        $display("  UART 8N1 framing  : %0d frames correct, %0d violations",
                 uart_frame_ok, uart_frame_err);
        $display("  I2C addr (0x5E)   : %s",
                 (i2c_addr_valid && i2c_addr_captured===8'h5E) ? "PASS" : "FAIL/not seen");
        $display("  I2C data (0x7D)   : %s",
                 (i2c_data_valid && i2c_data_captured===8'h7D) ? "PASS" : "FAIL/not seen");
        $display("  SPI CS duration   : %0d correct (16 SCK), %0d violations",
                 spi_cs_spec_ok, spi_cs_spec_err);
        $display("  BSG flit format   : %0d bursts checked, %0d violations",
                 bsg_burst_count, bsg_flit_spec_err);
        $display("  Mux sequencing    : %0d transitions correct, %0d violations",
                 mux_seq_ok, mux_seq_err);
        if (uart_baud_err + uart_frame_err + i2c_spec_err +
            spi_cs_spec_err + bsg_flit_spec_err + mux_seq_err == 0)
            $display("==== SPEC ALL PASS ====");
        else
            $display("==== SPEC FAILURES DETECTED ====");
    end

endmodule
