JefferyWenn/EE400-Chip-Testing/chip/zeroscatter/design/tactile-ctrl-chip/v/top/chip_top_tb_ex.sv

// -----------------------------------------------------------------------
// chip_top_tb.sv
//
// Combined SPI + bsg_link testbench for chip_top.sv.
//
// Setup:
//   - Drive chip's RX-side pads from a peer bsg_link_ddr_upstream
//     instance acting as the FPGA TX endpoint.
//   - Capture chip's TX-side pads with a peer bsg_link_ddr_downstream
//     instance acting as the FPGA RX endpoint.
//   - SPI master driven from a simple task.
//
// Test sequence:
//   1) Reset all link / token / core resets in stages.
//   2) Wait for the chip's status TX to become valid.
//   3) Send 10 bsg_link RX words ("config write") to set link_cfg_active.
//   4) Verify chip's TX status echoes link_cfg_active=1 and rx_word_count.
//   5) SPI write that asserts spi_reg_enable.
//   6) Verify chip's TX status echoes spi_reg_enable=1.
// -----------------------------------------------------------------------
`timescale 1ps/1ps

module chip_top_tb;

    localparam int FLIT_WIDTH    = 16;
    localparam int CHANNEL_WIDTH = 8;

    // ----- Clocks + global control -----
    logic core_clk;
    logic dn_io_clk;          // FPGA's TX I/O master clock; bsg_link_oddr_phy ÷2 → 50 MHz forwarded to PAD[8]
    logic hard_reset;

    // ----- Reset stages (mirrors bsg_link reference tb staging) -----
    logic fpga_core_reset;
    logic fpga_tx_io_link_reset;
    logic fpga_tx_async_token_reset;
    logic fpga_rx_io_link_reset;
    logic fpga_rx_io_link_reset_sync;

    // ----- Pad bus -----
    wire vdd_io = 1'b1;
    wire vss_io = 1'b0;
    tri  [47:0] pad;
    logic [47:0] pad_drv;
    logic [47:0] pad_oe;

    function automatic logic kz(input logic v);
        kz = (v === 1'b1) ? 1'b1 : 1'b0;
    endfunction

    genvar pad_idx;
    generate
        for (pad_idx = 0; pad_idx < 48; pad_idx++) begin : gen_pad_drive
            assign pad[pad_idx] = pad_oe[pad_idx] ? pad_drv[pad_idx] : 1'bz;
        end
    endgenerate

    chip_top uut (
        .PAD   (pad),
        .VDDPST(vdd_io),
        .VSSPST(vss_io),
        .VDD   (vdd_io),
        .VSS   (vss_io)
    );

    // ----- bsg_link wires shared with chip's PAD bus -----
    logic                       fpga_to_asic_clk;
    logic                       fpga_to_asic_valid;
    logic [CHANNEL_WIDTH-1:0]   fpga_to_asic_data;
    logic                       fpga_to_asic_token;   // FPGA RX -> chip TX token_clk
    logic                       asic_to_fpga_token;   // chip RX -> FPGA TX token
    logic                       asic_to_fpga_clk;
    logic                       asic_to_fpga_valid;
    logic [CHANNEL_WIDTH-1:0]   asic_to_fpga_data;

    // Drive chip's RX-side pads
    assign pad_drv[44] = kz(core_clk);
    assign pad_drv[45] = kz(hard_reset);
    assign pad_drv[8]  = kz(fpga_to_asic_clk);
    assign pad_drv[9]  = kz(fpga_to_asic_valid);

    // dn_data interleave per chip_top.sv's dn_data_pad():
    //   bits[0..7]  -> PAD[0..7]
    //   bit  8 -> PAD[37], bit  9 -> PAD[36],
    //   bit 10 -> PAD[39], bit 11 -> PAD[38],
    //   bit 12 -> PAD[41], bit 13 -> PAD[40],
    //   bit 14 -> PAD[43], bit 15 -> PAD[42]
    assign pad_drv[0]  = kz(fpga_to_asic_data[0]);
    assign pad_drv[1]  = kz(fpga_to_asic_data[1]);
    assign pad_drv[2]  = kz(fpga_to_asic_data[2]);
    assign pad_drv[3]  = kz(fpga_to_asic_data[3]);
    assign pad_drv[4]  = kz(fpga_to_asic_data[4]);
    assign pad_drv[5]  = kz(fpga_to_asic_data[5]);
    assign pad_drv[6]  = kz(fpga_to_asic_data[6]);
    assign pad_drv[7]  = kz(fpga_to_asic_data[7]);


    // chip's token_clk input PAD[12] receives the FPGA RX-side token
    // (the returned-credit signal generated by fpga_rx_link.core_token_r_o).
    assign pad_drv[12] = kz(fpga_to_asic_token);

    // SPI controls
    logic SCLK, MOSI, SS_n;
    wire  MISO;
    assign pad_drv[13] = kz(SCLK);
    assign pad_drv[24] = kz(MOSI);
    assign pad_drv[26] = kz(SS_n);
    assign MISO         = pad[25];

    // DFT scan inputs tied off in functional sim
    assign pad_drv[11] = 1'b0;
    assign pad_drv[46] = 1'b0;

    // Sample chip's TX-side pads
    assign asic_to_fpga_clk   = pad[15];
    assign asic_to_fpga_valid = pad[14];
    assign asic_to_fpga_token = pad[10];

    // up_data interleave per chip_top.sv's up_data_pad()
    assign asic_to_fpga_data[0]  = pad[22];
    assign asic_to_fpga_data[1]  = pad[23];
    assign asic_to_fpga_data[2]  = pad[20];
    assign asic_to_fpga_data[3]  = pad[21];
    assign asic_to_fpga_data[4]  = pad[18];
    assign asic_to_fpga_data[5]  = pad[19];
    assign asic_to_fpga_data[6]  = pad[16];
    assign asic_to_fpga_data[7]  = pad[17];


    // ----- FPGA-side bsg_link instances (peers to chip's wrapper) -----
    logic [FLIT_WIDTH-1:0] fpga_tx_data;
    logic                  fpga_tx_valid;
    logic                  fpga_tx_ready;
    logic [FLIT_WIDTH-1:0] fpga_rx_data;
    logic                  fpga_rx_valid;
    logic                  fpga_rx_yumi;
    bsg_link_ddr_upstream #(
        .width_p        (FLIT_WIDTH),
        .channel_width_p(CHANNEL_WIDTH),
        .num_channels_p (1),
        .lg_fifo_depth_p(6)
    ) fpga_tx_link (
        .core_clk_i         (core_clk),
        .core_link_reset_i  (fpga_core_reset),
        .core_data_i        (fpga_tx_data),
        .core_valid_i       (fpga_tx_valid),
        .core_ready_o       (fpga_tx_ready),
        .io_clk_i           (dn_io_clk),
        .io_link_reset_i    (fpga_tx_io_link_reset),
        .async_token_reset_i(fpga_tx_async_token_reset),
        .io_clk_r_o         (fpga_to_asic_clk),
        .io_data_r_o        (fpga_to_asic_data),
        .io_valid_r_o       (fpga_to_asic_valid),
        .token_clk_i        (asic_to_fpga_token)
    );

    bsg_sync_sync #(.width_p(1)) fpga_rx_reset_sync (
        .oclk_i      (asic_to_fpga_clk),
        .iclk_data_i (fpga_rx_io_link_reset),
        .oclk_data_o (fpga_rx_io_link_reset_sync)
    );

    bsg_link_ddr_downstream #(
        .width_p        (FLIT_WIDTH),
        .channel_width_p(CHANNEL_WIDTH),
        .num_channels_p (1),
        .lg_fifo_depth_p(6)
    ) fpga_rx_link (
        .core_clk_i        (core_clk),
        .core_link_reset_i (fpga_core_reset),
        .io_link_reset_i   (fpga_rx_io_link_reset_sync),
        .core_data_o       (fpga_rx_data),
        .core_valid_o      (fpga_rx_valid),
        .core_yumi_i       (fpga_rx_yumi),
        .io_clk_i          (asic_to_fpga_clk),
        .io_data_i         (asic_to_fpga_data),
        .io_valid_i        (asic_to_fpga_valid),
        .core_token_r_o    (fpga_to_asic_token)
    );

    assign fpga_rx_yumi = fpga_rx_valid;

    // Track FPGA-side RX from chip
    logic [FLIT_WIDTH-1:0] fpga_last_rx_data;
    integer                fpga_rx_count;
    always_ff @(posedge core_clk) begin
        if (fpga_core_reset) begin
            fpga_rx_count     <= 0;
            fpga_last_rx_data <= '0;
        end else if (fpga_rx_valid && fpga_rx_yumi) begin
            fpga_rx_count     <= fpga_rx_count + 1;
            fpga_last_rx_data <= fpga_rx_data;
        end
    end

    // ----- Clock generation -----
    initial begin
        dn_io_clk = 1'b0;
        @(negedge hard_reset);              // hard_reset이 0이 될 때까지 대기
        repeat (50) @(posedge core_clk);    // 칩 downstream FIFO 리셋 완료 대기
        forever #10000 dn_io_clk = ~dn_io_clk;   // 50 MHz
    end

    // initial begin
    //     dn_io_clk = 1'b0;
    //     forever #10000 dn_io_clk = ~dn_io_clk;    // 50 MHz → bsg_link_oddr_phy ÷2 → 25 MHz forwarded clock at PAD[8]
    // end

    // ----- Stimulus tasks -----
    task automatic send_link_word(input logic [FLIT_WIDTH-1:0] data);
        begin
            fpga_tx_data  <= data;
            fpga_tx_valid <= 1'b1;
            do begin
                @(posedge core_clk);
            end while (!fpga_tx_ready);
            fpga_tx_valid <= 1'b0;
            @(posedge core_clk);
        end
    endtask

    // Bit-banged SPI write of 298 bits (rw_bit=0 + 297 data bits MSB-first).
    // The first data bit (MSB after rw_bit) becomes reg_out[297] = spi_reg_enable.
    task automatic spi_write(input logic [297:0] data);
        integer i;
        begin
            @(negedge SCLK);
            SS_n = 1'b0;
            MOSI = 1'b0;          // rw_bit = 0 (write)
            @(negedge SCLK);
            for (i = 297; i >= 0; i = i - 1) begin
                MOSI = data[i];
                @(negedge SCLK);
            end
            @(negedge SCLK);
            @(negedge SCLK);
            SS_n = 1'b1;
        end
    endtask

    // SPI clock generation (4 MHz)
    initial begin
        SCLK = 1'b0;
        forever #125000 SCLK = ~SCLK;
    end

    // ----- Main test sequence -----
    initial begin
        // VCD for legacy/open-source viewers; FSDB for Verdi
        // (`make view-sim-rtl`, `make view-sim-syn`, `make view-sim-par`).
        // FSDB lives in the run dir alongside simv with the canonical
        // name Hammer's vcs-mk view-sim-* targets look for.
        $dumpfile("chip_top_tb.vcd");
        $dumpvars(0, chip_top_tb);
        $fsdbDumpfile("waveform.fsdb");
        $fsdbDumpvars(0, chip_top_tb);
        $fsdbDumpMDA();   // pack arrays so DDR data buses stay readable

        hard_reset                = 1'b1;
        fpga_core_reset           = 1'b1;
        fpga_tx_io_link_reset     = 1'b1;
        fpga_tx_async_token_reset = 1'b0;
        fpga_rx_io_link_reset     = 1'b1;
        fpga_tx_valid             = 1'b0;
        fpga_tx_data              = '0;
        SS_n                      = 1'b1;
        MOSI                      = 1'b0;
        pad_oe                    = '0;

        // Let chip_top configure pad directions first.
        #1000;
        pad_oe[44] = 1'b1; pad_oe[45] = 1'b1;
        pad_oe[8]  = 1'b1; pad_oe[9]  = 1'b1;
        pad_oe[12] = 1'b1;
        pad_oe[13] = 1'b1; pad_oe[24] = 1'b1; pad_oe[26] = 1'b1;
        pad_oe[11] = 1'b1; pad_oe[46] = 1'b1;
        for (int dn = 0; dn < 8; dn++) pad_oe[dn] = 1'b1;
        // pad_oe[37] = 1'b1; pad_oe[36] = 1'b1;
        // pad_oe[39] = 1'b1; pad_oe[38] = 1'b1;
        // pad_oe[41] = 1'b1; pad_oe[40] = 1'b1;
        // pad_oe[43] = 1'b1; pad_oe[42] = 1'b1;

        // Reset bring-up order for our chip:
        //  1) Pulse FPGA TX async_token_reset (chip RX side will see tokens
        //     once data starts flowing).
        //  2) Release FPGA TX I/O link reset (FPGA TX starts driving the
        //     chip's RX-side data clock).
        //  3) Release chip's hard_reset. The chip's internal reset
        //     sequencer takes ~32 core_clks to bring its bsg_link out of
        //     reset (async_token pulse, io_link, then core).
        //  4) After the chip is running, release FPGA RX I/O link reset
        //     so the FPGA RX side sees a valid up_clk from the chip.
        //  5) Release FPGA core reset.
        // repeat (8) @(posedge core_clk);
        // fpga_tx_async_token_reset = 1'b1;
        // repeat (2) @(posedge core_clk);
        // fpga_tx_async_token_reset = 1'b0;

        // repeat (8) @(posedge dn_io_clk);
        // fpga_tx_io_link_reset = 1'b0;

        // Release chip's hard_reset; wait for its internal sequencer to
        // finish (>=32 core_clks).
        repeat (8) @(posedge core_clk);
        hard_reset = 1'b0;
        repeat (64) @(posedge core_clk);

        fpga_tx_async_token_reset = 1'b1;
        repeat (2) @(posedge core_clk);
        fpga_tx_async_token_reset = 1'b0;

        repeat (8) @(posedge dn_io_clk);
        fpga_tx_io_link_reset = 1'b0;

        // Now the chip is driving up_clk; safe to bring up FPGA RX.
        fpga_rx_io_link_reset = 1'b0;
        repeat (8) @(posedge core_clk);
        fpga_core_reset = 1'b0;

        // Let chip exit reset and start emitting status words
        repeat (200) @(posedge core_clk);
        $display("post-reset: rx_count=%0d, last_status=%h",
                 fpga_rx_count, fpga_last_rx_data);

        // Test 1: bsg_link config write (10 words)
        $display("Test 1: send 10 bsg_link config words to chip RX");
        for (int w = 0; w < 10; w++) begin
            //send_link_word(32'hC0DE_0000 | w);
            send_link_word(16'hC000 | w[15:0]);
        end
        repeat (200) @(posedge core_clk);

        if (fpga_last_rx_data[3] !== 1'b1) begin
            $display("WARN: expected link_cfg_active=1 in chip status, got status=%h",
                     fpga_last_rx_data);
        end else begin
            $display("Test 1 PASS: link_cfg_active=1, rx_word_count=%0d, status=%h",
                     fpga_last_rx_data[15:8], fpga_last_rx_data);
        end

        // Test 2: SPI write with spi_reg_enable=1
        $display("Test 2: SPI write with spi_reg_enable=1");
        spi_write({
            1'b1,                                                              // spi_reg_enable
            1'b1,                                                              // transmit_enable
            232'hAABBCCDDEEFF00112233445566778899AABBCCDDEEFF00112233445566,   // packet_in
            8'd2, 8'd64, 16'd20000, 8'd8, 8'd16, 8'd10, 8'd20
        });
        repeat (1000) @(posedge core_clk);

        if (fpga_last_rx_data[2] !== 1'b1) begin
            $display("WARN: expected spi_reg_enable=1 in chip status, got status=%h",
                     fpga_last_rx_data);
        end else begin
            $display("Test 2 PASS: spi_reg_enable=1, status=%h", fpga_last_rx_data);
        end

        $display("BSG_LINK_PAD_LOOPBACK_PASS rx_count=%0d last_status=%h",
                 fpga_rx_count, fpga_last_rx_data);
        $finish;
    end

    // Watchdog
    initial begin
        #50_000_000_000;  // 50 us
        $display("ERROR: testbench watchdog expired");
        $finish;
    end

endmodule
