JefferyWenn/EE400-Chip-Testing/fpga/chip/chip_fpga_top.sv

// The chip on the FPGA, unchanged.
// Every pad is its own pin. They're inout (and must stay wire)
// because the chip's pad cells decide the direction, like on the real chip.

module chip_fpga_top (
    inout  wire [7:0] dn_data,     // PAD 0-7
    inout  wire       dn_clk,      // PAD 8
    inout  wire       dn_valid,    // PAD 9
    inout  wire       dn_token,    // PAD 10
    inout  wire       token_clk,   // PAD 12
    inout  wire       up_valid,    // PAD 14
    inout  wire       up_clk,      // PAD 15
    inout  wire [7:0] up_data,     // PAD 16-23
    inout  wire       spi_sclk,    // PAD 13
    inout  wire       spi_miso,    // PAD 25
    inout  wire       spi_cs_n,    // PAD 26
    inout  wire       uart_rx,     // PAD 24
    inout  wire       uart_tx,     // PAD 27
    inout  wire       i2c_scl,     // PAD 28
    inout  wire       i2c_sda,     // PAD 29
    inout  wire [3:0] mux_row,     // PAD 36-39
    inout  wire [3:0] mux_col,     // PAD 40-43
    inout  wire       core_clk,    // PAD 44
    inout  wire       hard_reset,  // PAD 45, 1 = reset
    inout  wire       scan_en,     // PAD 11, must be 0
    inout  wire       scan_in,     // PAD 46
    inout  wire       scan_out,    // PAD 47
    input  logic [9:0] SW,
    output logic [9:0] LEDR
);

    // SW0 can also hold the chip in reset
    wire reset_mix = hard_reset | SW[0];

    wire [5:0] unused_pads;   // PAD 30-35

    chip_top u_chip (
        .PAD ({ scan_out, scan_in, reset_mix, core_clk,                  // 47-44
                mux_col, mux_row,                                        // 43-36
                unused_pads,                                             // 35-30
                i2c_sda, i2c_scl, uart_tx, spi_cs_n, spi_miso, uart_rx,  // 29-24
                up_data[1], up_data[0], up_data[3], up_data[2],          // 23-20
                up_data[5], up_data[4], up_data[7], up_data[6],          // 19-16
                up_clk, up_valid, spi_sclk, token_clk,                   // 15-12
                scan_en, dn_token, dn_valid, dn_clk,                     // 11-8
                dn_data }),                                              // 7-0
        .VDDPST (), .VSSPST (), .VDD (), .VSS ()
    );

    chip_leds u_leds (
        .clk      (core_clk),
        .reset    (reset_mix),
        .uart_tx  (uart_tx),
        .spi_cs_n (spi_cs_n),
        .up_valid (up_valid),
        .dn_valid (dn_valid),
        .led      (LEDR)
    );

endmodule
