JefferyWenn/EE400-Chip-Testing/fpga/chip/rtl/basejump/bsg_link_source_sync_upstream.v

//
// Prof. Taylor   7/24/2014
// <prof.taylor@gmail.com>
//
// Updated by Paul Gao 02/2019
//
//
// this implements:
//     - outgoing source-synchronous launch flops
//     - outgoing token channel to go from core domain deque to out of chip
//     - outgoing source-synchronous launch flops for token
//     - center-aligned DDR source sync output clock
//
// General reset procedures:
//
// Step 1: Assert io_link_reset_i and core_link_reset_i.
// Step 2: async_token_reset_i must be posedge/negedge toggled (0->1->0) 
//         at least once. token_clk_i cannot toggle during this step.
// Step 3: io_clk_i posedge toggled at least four times after that.
// Step 4: Deassert io_link_reset_i. 
// Step 5: Deassert core_link_reset_i. 
//
// *************************************************************************
//              async_token_reset_i    io_link_reset_i    core_link_reset_i
//  Step 1               0                    1                   1
//  Step 2               1                    1                   1
//  Step 3               0                    1                   1
//  Step 4               0                    0                   1
//  Step 5               0                    0                   0
// *************************************************************************
//
//


`include "bsg_defines.v"

module bsg_link_source_sync_upstream

     #(  parameter channel_width_p                 = 16
       , parameter lg_fifo_depth_p                 = 6
       , parameter lg_credit_to_token_decimation_p = 3
       , parameter bypass_twofer_fifo_p            = 0

       // we explicit set the "inactive pattern"
       // on data lines when valid bit is not set
       //  to (10)+ = 0xA*
       //
       // the inactive pattern should balance the current
       // across I/O V33 and VZZ pads, reducing
       // electromigration for the common case of not
       // sending.
       //
       // for example, in TSMC 250, the EM limit is 41 mA
       // and the ratio of signal to I/O V33 and VZZ is
       // 4:1:1.
       //
       // fixme: an alternative might be to tri-state
       // the output, but further analysis is required
       // as to whether this is a good idea.
       
       // this default is only safe because we assume that only data bits are
       // being specified in the channel and no control bits, and that these data bits
       // are otherwise ignored by the receiver control logic if the output of this module 
       // is indicated as invalid.
       , parameter inactive_pattern_p = {channel_width_p { 2'b10 } }
       )
       
   (// control signals  
      input                         core_clk_i
    , input                         core_link_reset_i
    , input                         io_clk_i
    , input                         io_link_reset_i
    , input                         async_token_reset_i
    
    // Input from chip core
    , input [channel_width_p-1:0]   core_data_i
    , input                         core_valid_i
    , output                        core_ready_o

    // output channel to ODDR_PHY
    , output logic  [channel_width_p-1:0] io_data_o    // output data
    , output logic                        io_valid_o   // output valid
    , input                               io_ready_i   // output PHY is ready
    , input                               token_clk_i  // input token clock
   );
   generate // FPGA (Quartus Lite) needs explicit generate


  logic core_fifo_valid, core_fifo_yumi;
  logic [channel_width_p-1:0] core_fifo_data;

  logic core_async_fifo_full;
  assign core_fifo_yumi = core_fifo_valid & ~core_async_fifo_full;

  // MBT: we insert a two-element fifo here to
  // decouple the async fifo logic which can be on the critical
  // path in some cases. possibly this is being overly conservative
  // and may introduce too much latency. but certainly in the
  // case of the bsg_comm_link code, it is necessary.
  // fixme: possibly make it a parameter as to whether we instantiate
  // this fifo

  if (bypass_twofer_fifo_p == 0)
  begin: twofer
    bsg_two_fifo
   #(.width_p(channel_width_p)
    ) fifo
    (.clk_i  (core_clk_i)
    ,.reset_i(core_link_reset_i)
    ,.ready_o(core_ready_o)
    ,.data_i (core_data_i)
    ,.v_i    (core_valid_i)
    ,.v_o    (core_fifo_valid)
    ,.data_o (core_fifo_data)
    ,.yumi_i (core_fifo_yumi)
    );
  end
  else
  begin: no_twofer
    // keep async_fifo isolated when reset is asserted
    assign core_fifo_valid = core_valid_i;
    assign core_fifo_data  = core_data_i;
    assign core_ready_o    = (core_link_reset_i)? 1'b1 : ~core_async_fifo_full;
  end
  
  logic io_async_fifo_valid, io_async_fifo_yumi;
  logic [channel_width_p-1:0] io_async_fifo_data;
  
  
  // ******************************************
  // clock-crossing async fifo
  // this is just an output fifo and does not
  // need to cover the round trip latency
  // of the channel; just the clock domain crossing
  //
  // Assuming (A and B are registers with the corresponding clocks)
  // this is the structure of the roundtrip path:
  //
  //                 /--  B <-- B <-- A <--\
  //                |                      |
  //                 \--> B --> A --> A ---/
  //
  // Suppose we have cycleTimeA and cycleTimeB, with cycleTimeA > cycleTimeB
  // the bandwidth*delay product of the roundtrip is:
  //
  //   3 * (cycleTimeA + cycleTimeB) * min(1/cycleTimeA, 1/cycleTimeB)
  // = 3 + 3 * cycleTimeB / cycleTimeA
  //
  // w.c. is cycleTimeB == cycleTimeA
  //
  // --> 6 elements
  //
  // however, for the path from A to B and B to A
  // we need to clear not only the cycle time of A/B
  // but the two setup times, which are guaranteed to
  // be less than a cycle each. So we get 8 elements total.
  //
  
  // TODO: if we use 3-cycle synchronizers, then the async fifo would have to be larger.
   
  bsg_async_fifo
 #(.lg_size_p(3)
  ,.width_p(channel_width_p)
  ) async_fifo
  (.w_clk_i  (core_clk_i)
  ,.w_reset_i(core_link_reset_i)

  ,.w_enq_i  (core_fifo_yumi)
  ,.w_data_i (core_fifo_data)
  ,.w_full_o (core_async_fifo_full)

  ,.r_clk_i  (io_clk_i)
  ,.r_reset_i(io_link_reset_i)

  ,.r_deq_i  (io_async_fifo_yumi)
  ,.r_data_o (io_async_fifo_data)
  ,.r_valid_o(io_async_fifo_valid)
  );
  

   // ******************************************
   // Output valid and data signals
   
   
   // when fifo has valid data and token credit is available
   logic io_valid_n;
   
   always_comb
     begin
        // By default, data output is inactive pattern
        io_data_o = inactive_pattern_p[0+:channel_width_p];
        if (io_link_reset_i)
          begin
             io_valid_o = 1'b0;
          end
        else
          begin
             // subtle: we assert the real data rather than the inactive_pattern when we have 
             // valid data and enough credit, even if the serdes is not ready to send, since 
             // the data is ignored and it will reduce spurious switching.
             io_valid_o = io_valid_n;
             if (io_valid_n)
               io_data_o = io_async_fifo_data;
          end
     end

   // we need to track whether the credits are coming from
   // posedge or negedge tokens.

   // high bit indicates which counter we are grabbing from
   logic [lg_credit_to_token_decimation_p+1-1:0] io_token_alternator_r;
   
   // Increase token alternator when dequeue from async fifo
   bsg_counter_clear_up 
  #(.max_val_p({(lg_credit_to_token_decimation_p+1){1'b1}})
   ,.init_val_p(0) // this will start us on the posedge token
   ,.disable_overflow_warning_p(1) // Allow overflow for this counter
   )
   token_alt
   (.clk_i  (io_clk_i)
   ,.reset_i(io_link_reset_i)
   ,.clear_i(1'b0)
   ,.up_i   (io_async_fifo_yumi)
   ,.count_o(io_token_alternator_r)
   );

   // high bit set means we have exceeded number of posedge credits
   // and are doing negedge credits
   wire io_on_negedge_token = io_token_alternator_r[lg_credit_to_token_decimation_p];

   logic io_negedge_credits_avail, io_posedge_credits_avail;

   wire io_credit_avail = io_on_negedge_token
        ? io_negedge_credits_avail
        : io_posedge_credits_avail;

   // we send if we have both data to send and credits to send with
   assign io_valid_n = io_credit_avail & io_async_fifo_valid;
   // dequeue from fifo when io_ready
   assign io_async_fifo_yumi = io_valid_n & io_ready_i;

   wire io_negedge_credits_deque = io_async_fifo_yumi & io_on_negedge_token;
   wire io_posedge_credits_deque = io_async_fifo_yumi & ~io_on_negedge_token;

   // **********************************************
   // token channel
   //
   // these are tokens coming from off chip that need to
   // cross into the io clock domain.
   //
   // note that we are a little unconventional here; we use the token
   // itself as a clock. this because we don't know the phase of the
   // token signal coming in.
   //
   // we count both edges of the token separately, and assume that they
   // will alternate in lock-step. we use two separate counters to do this.
   //
   // an alternative would be to use
   // dual-edged flops, but they are not available in most ASIC libraries
   // and although you can synthesize these out of XOR'd flops, they
   // violate the async maxim that all signals crossing clock boundaries
   // must come from a launch flop.

   bsg_async_credit_counter
     #(// half the credits will be positive edge tokens
       .max_tokens_p(2**(lg_fifo_depth_p-1-lg_credit_to_token_decimation_p))
       ,.lg_credit_to_token_decimation_p(lg_credit_to_token_decimation_p)
       ,.count_negedge_p(1'b0)
       // we enable extra margin in case downstream module wants more tokens
       ,.extra_margin_p(2)
       ,.start_full_p(1)
       ,.use_async_w_reset_p(1'b1)
       ) pos_credit_ctr
       (
        .w_clk_i   (token_clk_i)
        ,.w_inc_token_i(1'b1)
        ,.w_reset_i(async_token_reset_i)

        // the I/O clock domain is responsible for tabulating tokens
        ,.r_clk_i             (io_clk_i                )
        ,.r_reset_i           (io_link_reset_i         )
        ,.r_dec_credit_i      (io_posedge_credits_deque)
        ,.r_infinite_credits_i(1'b0                    )
        ,.r_credits_avail_o   (io_posedge_credits_avail)
        );

   bsg_async_credit_counter
     #(// half the credits will be negative edge tokens
       .max_tokens_p(2**(lg_fifo_depth_p-1-lg_credit_to_token_decimation_p))
       ,.lg_credit_to_token_decimation_p(lg_credit_to_token_decimation_p)
       ,.count_negedge_p(1'b1)
       // we enable extra margin in case downstream module wants more tokens
       ,.extra_margin_p(2)
       ,.start_full_p(1)
       ,.use_async_w_reset_p(1'b1)
       ) neg_credit_ctr
       (
        .w_clk_i   (token_clk_i)
        ,.w_inc_token_i(1'b1)
        ,.w_reset_i(async_token_reset_i)

        // the I/O clock domain is responsible for tabulating tokens
        ,.r_clk_i             (io_clk_i                )
        ,.r_reset_i           (io_link_reset_i         )
        ,.r_dec_credit_i      (io_negedge_credits_deque)
        ,.r_infinite_credits_i(1'b0                    )
        ,.r_credits_avail_o   (io_negedge_credits_avail)
        );


endgenerate
endmodule
