JefferyWenn/EE400-Chip-Testing/fpga/chip/rtl/basejump/bsg_defines.v

`ifndef BSG_DEFINES_V
`define BSG_DEFINES_V

`define BSG_MAX(x,y) (((x)>(y)) ? (x) : (y))
`define BSG_MIN(x,y) (((x)<(y)) ? (x) : (y))

`define BSG_SIGN_EXTEND(sig, width) \
  ({{`BSG_MAX(width-$bits(sig),0){sig[$bits(sig)-1]}}, sig[0+:`BSG_MIN(width, $bits(sig))]})
`define BSG_ZERO_EXTEND(sig, width) \
  ({{`BSG_MAX(width-$bits(sig),0){1'b0}}, sig[0+:`BSG_MIN(width, $bits(sig))]})

// place this macro at the end of a verilog module file if that module has invalid parameters
// that must be specified by the user. this will prevent that module from becoming a top-level
// module per the discussion here: https://github.com/SymbiFlow/sv-tests/issues/1160 and the
// SystemVerilog Standard

//    "Top-level modules are modules that are included in the SystemVerilog
//    source text, but do not appear in any module instantiation statement, as
//    described in 23.3.2. This applies even if the module instantiation appears
//    in a generate block that is not itself instantiated (see 27.3). A design
//    shall contain at least one top-level module. A top-level module is
//    implicitly instantiated once, and its instance name is the same as the
//    module name. Such an instance is called a top-level instance."
//  

// FPGA (Quartus Lite): lint-only helper module removed
`define BSG_ABSTRACT_MODULE(fn)

// macro for defining invalid parameter; with the abstract module declaration
// it should be sufficient to omit the "inv" but we include this for tool portability
// if later we find that all tools are compatible, we can remove the use of this from BaseJump STL

`ifdef XCELIUM // Bare default parameters are incompatible as of 20.09.012
               // = "inv" causes type inference mismatch as of 20.09.012
`define BSG_INV_PARAM(param) param = -1
`elsif YOSYS // Bare default parameters are incompatible as of 0.9
`define BSG_INV_PARAM(param) param = "inv"
`else // VIVADO, DC, VERILATOR, GENUS
`define BSG_INV_PARAM(param) param
`endif


// maps 1 --> 1 instead of to 0
`define BSG_SAFE_CLOG2(x) ( ((x)==1) ? 1 : $clog2((x)))
`define BSG_IS_POW2(x) ( (1 << $clog2(x)) == (x))
`define BSG_WIDTH(x) ($clog2(x+1))
`define BSG_SAFE_MINUS(x, y) (((x)<(y))) ? 0 : ((x)-(y))

// calculate ceil(x/y) 
`define BSG_CDIV(x,y) (((x)+(y)-1)/(y))

`ifdef SYNTHESIS
`define BSG_UNDEFINED_IN_SIM(val) (val)
`else
`define BSG_UNDEFINED_IN_SIM(val) ('X)
`endif

`ifdef VERILATOR
`define BSG_HIDE_FROM_VERILATOR(val)
`else
`define BSG_HIDE_FROM_VERILATOR(val) val
`endif

`ifdef SYNTHESIS
`define BSG_DISCONNECTED_IN_SIM(val) (val)
`elsif VERILATOR
`define BSG_DISCONNECTED_IN_SIM(val) (val)
`else
`define BSG_DISCONNECTED_IN_SIM(val) ('z)
`endif

// Ufortunately per the Xilinx forums, Xilinx does not define
// any variable that indicates that Vivado Synthesis is running
// so as a result we identify Vivado merely as the exclusion of
// Synopsys Design Compiler (DC). Support beyond DC and Vivado
// will require modification of this macro.

`ifdef SYNTHESIS
  `ifdef DC
  `define BSG_VIVADO_SYNTH_FAILS
  `elsif CDS_TOOL_DEFINE
  `define BSG_VIVADO_SYNTH_FAILS
  `else
  `define BSG_VIVADO_SYNTH_FAILS this_module_is_not_synthesizeable_in_vivado
  `endif
`else
`define BSG_VIVADO_SYNTH_FAILS
`endif

`define BSG_STRINGIFY(x) `"x`"


// For the modules that must be hardened, add this macro at the top.
`ifdef SYNTHESIS
`define BSG_SYNTH_MUST_HARDEN this_module_must_be_hardened
`else
`define BSG_SYNTH_MUST_HARDEN
`endif


// using C-style shifts instead of a[i] allows the parameter of BSG_GET_BIT to be a parameter subrange                                                                                                                                                                               
// e.g., parameter[4:1][1], which DC 2016.12 does not allow                                                                                                                                                                                                                          

`define BSG_GET_BIT(X,NUM) (((X)>>(NUM))&1'b1)

// This version of countones works in synthesis, but only up to 64 bits                                                                                                                                                                                                              
// we do a funny thing where we propagate X's in simulation if it is more than 64 bits                                                                                                                                                                                               
// and in synthesis, go ahead and ignore the high bits                                                                                                                                                                      

`define BSG_COUNTONES_SYNTH(y) (($bits(y) < 65) ? 1'b0 : `BSG_UNDEFINED_IN_SIM(1'b0)) + (`BSG_GET_BIT(y,0) +`BSG_GET_BIT(y,1) +`BSG_GET_BIT(y,2) +`BSG_GET_BIT(y,3) +`BSG_GET_BIT(y,4) +`BSG_GET_BIT(y,5) +`BSG_GET_BIT(y,6)+`BSG_GET_BIT(y,7) +`BSG_GET_BIT(y,8)+`BSG_GET_BIT(y,9) \
                                                                                       +`BSG_GET_BIT(y,10)+`BSG_GET_BIT(y,11)+`BSG_GET_BIT(y,12)+`BSG_GET_BIT(y,13)+`BSG_GET_BIT(y,14)+`BSG_GET_BIT(y,15)+`BSG_GET_BIT(y,16)+`BSG_GET_BIT(y,17)+`BSG_GET_BIT(y,18)+`BSG_GET_BIT(y,19) \
                                                                                       +`BSG_GET_BIT(y,20)+`BSG_GET_BIT(y,21)+`BSG_GET_BIT(y,22)+`BSG_GET_BIT(y,23)+`BSG_GET_BIT(y,24)+`BSG_GET_BIT(y,25)+`BSG_GET_BIT(y,26)+`BSG_GET_BIT(y,27)+`BSG_GET_BIT(y,28)+`BSG_GET_BIT(y,29) \
                                                                                       +`BSG_GET_BIT(y,30)+`BSG_GET_BIT(y,31)+`BSG_GET_BIT(y,32)+`BSG_GET_BIT(y,33)+`BSG_GET_BIT(y,34)+`BSG_GET_BIT(y,35)+`BSG_GET_BIT(y,36)+`BSG_GET_BIT(y,37)+`BSG_GET_BIT(y,38)+`BSG_GET_BIT(y,39) \
                                                                                       +`BSG_GET_BIT(y,40)+`BSG_GET_BIT(y,41)+`BSG_GET_BIT(y,42)+`BSG_GET_BIT(y,43)+`BSG_GET_BIT(y,44)+`BSG_GET_BIT(y,45)+`BSG_GET_BIT(y,46)+`BSG_GET_BIT(y,47)+`BSG_GET_BIT(y,48)+`BSG_GET_BIT(y,49) \
                                                                                       +`BSG_GET_BIT(y,50)+`BSG_GET_BIT(y,51)+`BSG_GET_BIT(y,52)+`BSG_GET_BIT(y,53)+`BSG_GET_BIT(y,54)+`BSG_GET_BIT(y,55)+`BSG_GET_BIT(y,56)+`BSG_GET_BIT(y,57)+`BSG_GET_BIT(y,58)+`BSG_GET_BIT(y,59) \
                                                                                       +`BSG_GET_BIT(y,60)+`BSG_GET_BIT(y,61)+`BSG_GET_BIT(y,62)+`BSG_GET_BIT(y,63))

// nullify rpgroups
`ifndef rpgroup
`define rpgroup(x)
`endif

// verilog preprocessing -> if defined(A) && defined(B) then define C
`define BSG_DEFIF_A_AND_B(A,B,C) \
    `undef C \
    `ifdef A \
        `ifdef B \
            `define C \
        `endif \
    `endif

// verilog preprocessing -> if defined(A) && !defined(B) then define C
`define BSG_DEFIF_A_AND_NOT_B(A,B,C) \
    `undef C \
    `ifdef A \
        `ifndef B \
            `define C \
        `endif \
    `endif

// verilog preprocessing -> if !defined(A) && defined(B) then define C
`define BSG_DEFIF_NOT_A_AND_B(A,B,C) `BSG_DEFIF_A_AND_NOT_B(B,A,C)

// verilog preprocessing -> if !defined(A) && !defined(B) then define C
`define BSG_DEFIF_NOT_A_AND_NOT_B(A,B,C) \
    `undef C \
    `ifndef A \
        `ifndef B \
            `define C \
        `endif \
    `endif

// verilog preprocessing -> if defined(A) || defined(B) then define C
`define BSG_DEFIF_A_OR_B(A,B,C) \
    `undef C \
    `ifdef A \
        `define C \
    `endif \
    `ifdef B \
        `define C \
    `endif

// verilog preprocessing -> if defined(A) || !defined(B) then define C
`define BSG_DEFIF_A_OR_NOT_B(A,B,C) \
    `undef C \
    `ifdef A \
        `define C \
    `endif \
    `ifndef B \
        `define C \
    `endif

// verilog preprocessing -> if !defined(A) || defined(B) then define C
`define BSG_DEFIF_NOT_A_OR_B(A,B,C) `BSG_DEFIF_A_OR_NOT_B(B,A,C)

// verilog preprocessing -> if !defined(A) || !defined(B) then define C
`define BSG_DEFIF_NOT_A_OR_NOT_B(A,B,C) \
    `undef C \
    `ifndef A \
        `define C \
    `endif \
    `ifndef B \
        `define C \
    `endif

`endif
