JefferyWenn/EE400-Chip-Testing/fpga/chip/rtl/basejump/bsg_two_fifo.v

// MBT 9-7-2014
//
// two element fifo
//
// helpful interface on both input and output
//
// input : ready/valid   flow control  (rv->&)
// output: valid->yumi   flow control ( v->r)
//
// see https://github.com/bespoke-silicon-group/basejump_stl/blob/master/docs/BaseJump_STL_DAC_2018_Camera_Ready.pdf
// to understand the flow control standards in BaseJump STL.
//
// INPUTS: although this module's inputs adheres to
// ready/valid protocol where both sender and receiver
// AND the two signals together to determine
// if transaction happened; in some cases, we
// know that the sender takes into account the
// ready signal before sending out valid, and the
// check is unnecessary. We use ready_THEN_valid_p
// to remove the check if it is unnecessary.
//
//
// note: ~v_o == fifo is empty.
//

`include "bsg_defines.v"

module bsg_two_fifo #(parameter `BSG_INV_PARAM(width_p)
                      , parameter verbose_p=0
                      // whether we should allow simultaneous enque and deque on full
                      , parameter allow_enq_deq_on_full_p=0
                      // necessarily, if we allow enq on ready low, then
                      // we are not using a ready/valid protocol
                      , parameter ready_THEN_valid_p=allow_enq_deq_on_full_p
                      )
   (input clk_i
    , input reset_i

    // input side
    , output              ready_o // early
    , input [width_p-1:0] data_i  // late
    , input               v_i     // late

    // output side
    , output              v_o     // early
    , output[width_p-1:0] data_o  // early
    , input               yumi_i  // late
    );
   generate // FPGA (Quartus Lite) needs explicit generate

   wire deq_i = yumi_i;
   wire enq_i;

   logic                  head_r,  tail_r;
   logic                  empty_r, full_r;

   bsg_mem_1r1w #(.width_p(width_p)
                  ,.els_p(2)
		  ,.read_write_same_addr_p(allow_enq_deq_on_full_p)
                  ) mem_1r1w
     (.w_clk_i   (clk_i  )
      ,.w_reset_i(reset_i)
      ,.w_v_i    (enq_i  )
      ,.w_addr_i (tail_r )
      ,.w_data_i (data_i )
      ,.r_v_i    (~empty_r)
      ,.r_addr_i (head_r )
      ,.r_data_o (data_o )
      );

   assign v_o       = ~empty_r;
   assign ready_o   = ~full_r;

   if (ready_THEN_valid_p)
     assign enq_i = v_i;
   else
     assign enq_i = v_i & ~full_r;

   always_ff @(posedge clk_i)
     begin
        if (reset_i)
          begin
             tail_r  <= 1'b0;
             head_r  <= 1'b0;
             empty_r <= 1'b1;
             full_r  <= 1'b0;
          end
        else
          begin
             if (enq_i)
               tail_r         <= ~tail_r;

             if (deq_i)
               head_r         <= ~head_r;

             // logic simplifies nicely for 2 element case
             empty_r             <= (   empty_r & ~enq_i)
                                    | (~full_r  &  deq_i & ~enq_i);

             if (allow_enq_deq_on_full_p)
               full_r              <= (  ~empty_r &  enq_i & ~deq_i)
                                      | ( full_r  & ~(deq_i^enq_i));
             else
               full_r              <= (  ~empty_r &  enq_i & ~deq_i)
                                      | ( full_r  & ~deq_i);
          end // else: !if(reset_i)
     end // always_ff @

   // synopsys translate_off
   always_ff @(posedge clk_i)
     begin
        if (~reset_i)
          begin
             assert ({empty_r, deq_i} !== 2'b11)
               else $error("invalid deque on empty fifo ", empty_r, deq_i);

             if (allow_enq_deq_on_full_p)
               begin
                  assert ({full_r,enq_i,deq_i}   !== 3'b110)
                    else $error("invalid enque on full fifo ", full_r, enq_i);
               end
             else
               assert ({full_r,enq_i}   !== 2'b11)
                 else $error("invalid enque on full fifo ", full_r, enq_i);

             assert ({full_r,empty_r} !== 2'b11)
               else $error ("fifo full and empty at same time ", full_r, empty_r);
          end // if (~reset_i)
     end // always_ff @

   always_ff @(posedge clk_i)
     if (verbose_p)
       begin
	  if (enq_i)
            $display("### %m enq %x onto fifo",data_i);

          if (deq_i)
            $display("### %m deq %x from fifo",data_o);
       end

   // for debugging
   wire [31:0] num_elements_debug = full_r + (empty_r==0);

   // synopsys translate_on

endgenerate
endmodule

`BSG_ABSTRACT_MODULE(bsg_two_fifo)
