JefferyWenn/EE400-Chip-Testing/chip/zeroscatter/design/tactile-ctrl-chip/c/firmware_data.h

#ifndef FIRMWARE_DATA_H
#define FIRMWARE_DATA_H

#include <stdint.h>
#include <avr/pgmspace.h>

const uint16_t FIRMWARE_WORD_COUNT = 251;

const uint32_t firmware_words[] PROGMEM = {
    0xFB010113UL,
    0x04112623UL,
    0x04812423UL,
    0x04912223UL,
    0x05212023UL,
    0x03312E23UL,
    0x03412C23UL,
    0x03512A23UL,
    0x03612823UL,
    0x03712623UL,
    0x03812423UL,
    0x03912223UL,
    0x03A12023UL,
    0x01B12E23UL,
    0x000057B7UL,
    0x0000C437UL,
    0x0007A023UL,
    0x00300493UL,
    0x00942823UL,
    0x2E8000EFUL,
    0x00700793UL,
    0x00F42823UL,
    0x2DC000EFUL,
    0x00942823UL,
    0x2D4000EFUL,
    0x2D0000EFUL,
    0x00100793UL,
    0x00F42823UL,
    0x2C4000EFUL,
    0x00042823UL,
    0x2BC000EFUL,
    0x00001737UL,
    0x0000D7B7UL,
    0xF0070713UL,
    0x00E7A823UL,
    0x0000D437UL,
    0x0000D7B7UL,
    0x0007A023UL,
    0x36000513UL,
    0x00007937UL,
    0x009899B7UL,
    0x00042223UL,
    0x00440413UL,
    0x258000EFUL,
    0x00490913UL,
    0x68098993UL,
    0x00007C37UL,
    0x00008CB7UL,
    0x00000B93UL,
    0x00005DB7UL,
    0x008C0C13UL,
    0x200C8C93UL,
    0x004B9D13UL,
    0x00000493UL,
    0x00449793UL,
    0x01A7E7B3UL,
    0x00FDA023UL,
    0x250000EFUL,
    0x000076B7UL,
    0x0006A023UL,
    0x10000593UL,
    0x01000613UL,
    0x00092783UL,
    0x0017F793UL,
    0xFE079CE3UL,
    0x000C2703UL,
    0x0174E7B3UL,
    0x00279793UL,
    0x00475713UL,
    0x019787B3UL,
    0x0FF77713UL,
    0x00E7A023UL,
    0x00148493UL,
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
    0x06000400UL,
    0x00030000UL,
    0x08000400UL,
    0x05870000UL,
    0x0A000400UL,
    0x25870080UL,
    0x0C000400UL,
    0x45870100UL,
    0x0E000400UL,
    0x65870180UL,
    0x10000400UL,
    0x85870200UL,
    0x12000400UL,
    0x00620000UL,
    0x14000400UL,
    0x00050000UL
};

#endif
