JefferyWenn/EE400-Chip-Testing/(commit log)

2026-10-14 Import final Zeroscatter tapeout design for chip bring-up
    Final tapeout RTL, firmware, testbenches and Hammer cfg (identical to
    momoka17/EE478-tactile-sensing-control branch 6662026 @ 9438d5d), the
    ee478-hammer flow with local plugin edits, final syn/PAR reports, and
    bring-up docs. GDS, netlists, SDF and waveforms stay local in artifacts/
    (git-ignored), as do the TSMC tech plugin and Mentor plugins.
2026-10-28 Add FPGA emulation project for the chip board (DE1-SoC)
    - fpga/common/tsmc_fpga_models.v: FPGA stand-ins for the TSMC cells used
    in chip_top (IO pad, power pads, reset set-flop, scan buffer)
    - fpga/chip/chip_fpga_top.v: unchanged chip_top on the GPIO headers
    (PAD 0-35 -> GPIO_0, PAD 36-47 -> GPIO_1[0..11]) + status LEDs
    - fpga/chip/rtl: copy of the final (Jun 6) chip RTL and BaseJump files
    - fpga/chip/chip.qpf/.qsf/.sdc: Quartus project for 5CSEMA5F31C6, pins
    from the DE1-SoC user manual, 10 MHz input clocks
    Not compiled yet (Quartus not installed).
2026-10-28 Make chip FPGA project pass Quartus Lite analysis
    Quartus Lite only supports an older SystemVerilog dialect, so the FPGA
    copies of BaseJump STL need syntax-only fixes (logic unchanged):
    - wrap module bodies in explicit generate/endgenerate
    - empty BSG_ABSTRACT_MODULE (lint-only dummy module)
    - localparam in parameter list -> parameter (ddr up/downstream)
    - bsg_scan: streaming bit-reverse -> explicit loop, name a block
    - bsg_fifo_1r1w_small: drop dead "hardened" branch (harden_p = 0)
    - add missing bsg_dff_reset.v (used by bsg_one_fifo)
    chip.qsf: read all sources as SystemVerilog, order BaseJump files so
    each module precedes its users, drop unused bsg_tag files.
    .gitignore: Quartus build outp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
2026-10-29 Add driver FPGA, new firmware, and two-board simulation
    Driver board (fpga/driver): 12.5 MHz clock, bsg_link start-up sequence,
    firmware loader over UART (plays the PC), fake ADC (pixel = cell number),
    fake CNN (counts/checks pixels, replies every frame), status display
    (fps, fewest pixels, sticky error LEDs, SW1 freeze). Quartus project with
    named pins from the DE1-SoC manual.
    Chip board: named pad ports, SW0 reset, status LEDs (chip_leds.v),
    12.5 MHz clocks.
    Firmware (fpga/firmware): new small firmware with a fixed linker script
    (1 KB IRAM, 256 B DRAM, stack at 0x100); sends frames from the CPU to
    avoid the DMA flit-drop bug; waits on CNN_BUF_ST.
    fpga/sim/system_tb.sv: both boards wired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
2026-10-29 Add one-board full-system FPGA project; SW1 sends firmware, HEX shows peak pressure
    - fpga/fullsys: test driver + chip on one DE1-SoC, JP1->JP2 loopback
    wires (SW2) and the real glove/ADC board
    - driver: SW1 up starts the firmware load; HEX5-4 fps, HEX3-2 strongest
    pixel in the last frame, HEX1-0 its row/column
2026-10-31 Add remaining tapeout build reports: signoff STA, DRC, LVS, DFT, formal
    From the local Hammer build in ee478-ctrl-chip/tapeout_v2/build:
    - signoff_sta/reports: timing-par-rundir reports (Jun 2), large ones gzipped
    - drc, lvs: drc-rundir / lvs-rundir results (Jun 2)
    - syn: DFT setup/chain/register reports (Jun 6)
    - par: init shield report, CTS summaries (Jun 6)
    - formal: LEC output cut from hammer.log (no report files are written);
    syn run Jun 1: only scan_out differs (DFT); par run May 27: older layout
    Note: this build's GDS (Jun 6) is not the submitted GDS (Jun 3 / Jun 29).
2026-10-31 Add signoff DRC and LVS results (Jun 2, logo GDS)
    From tapeout_v2/signoff_drc and signoff_lvs, run on
    logo/chip_top_signoff_logo.gds:
    - DRC: chip 1042 results (mostly ESD.25g/24g), antenna 0, wirebond 1
    - LVS: CORRECT
    Results match the Jun 29 submitted reports. Layout databases are not
    included. signoff_sta scripts were already in reports/signoff_sta.
2026-11-02 Run the FPGA emulation at 50 MHz; match driver and chip LEDs
    - driver: use CLOCK_50 directly (no /4), fps timer 25M ticks per 0.5 s,
    UART is now 115200 baud on both sides
    - LEDs: same order on both views (power, clock, firmware, boot, I2C,
    sensor data, link out, link in, UART, result packet); LED4 = I2C seen
    - LED blink and activity timers scaled for 50 MHz
    - sdc: all clocks 20 ns
2026-11-02 HEX pressure: flip the ADC value so a harder press shows a bigger number
    The glove's ADC value drops when pressed, so track 255 - value.
2026-11-03 FPGA emulation: SystemVerilog logic, simpler comments; add final report and zip
    - our FPGA files are now .sv and use logic (wire kept for inout pads,
    chip pad nets and tri-state); qsf files point to the .sv files
    - comments shortened in RTL, firmware, sdc and qsf (code unchanged;
    firmware rebuilds byte-identical)
    - system_tb.sv updated for the current driver (SW1 firmware, 50 MHz UART)
    - file/: Full-System FPGA Emulation report (submitted PDF)
    - zip/: submitted FPGA design zip
